VaughnLuce/LineFollowingRobot/README.md

# Line Following Robot
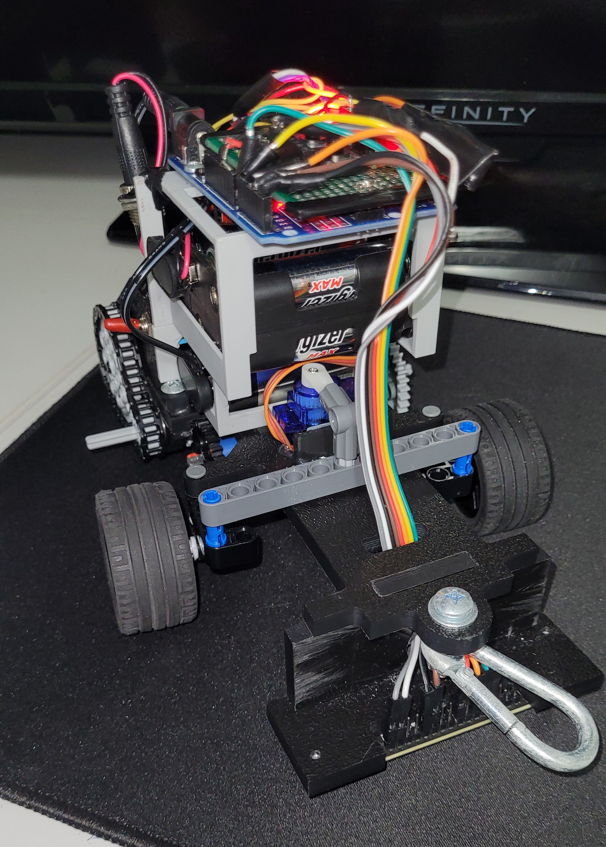
[picture p1: Images/Top.jpg]

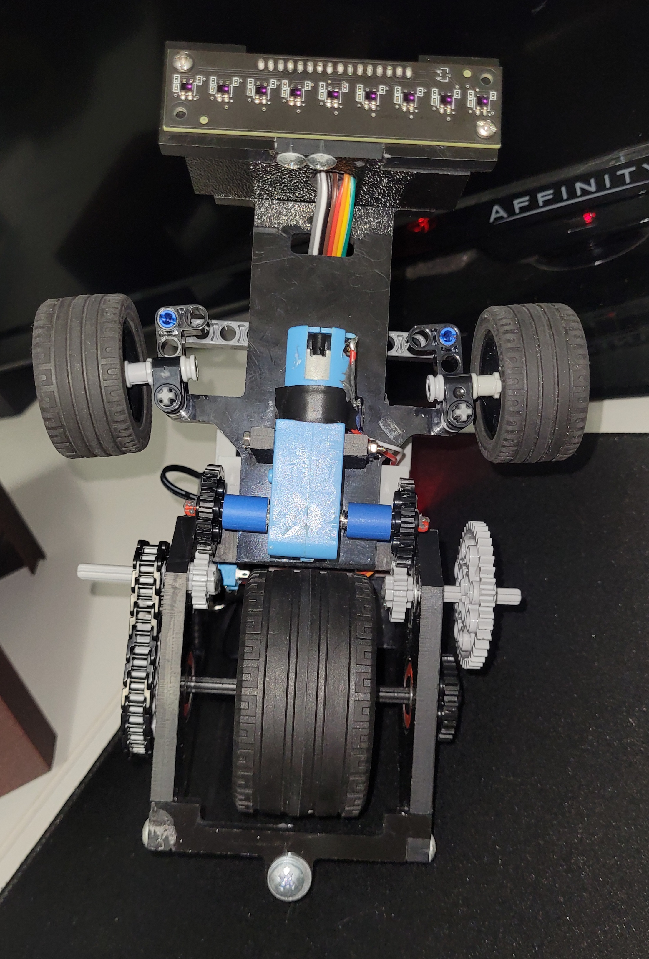
[picture p2: Images/Bottom.jpg]
