VaughnLuce/LineFollowingRobot/FinalDesignPackage.pdf

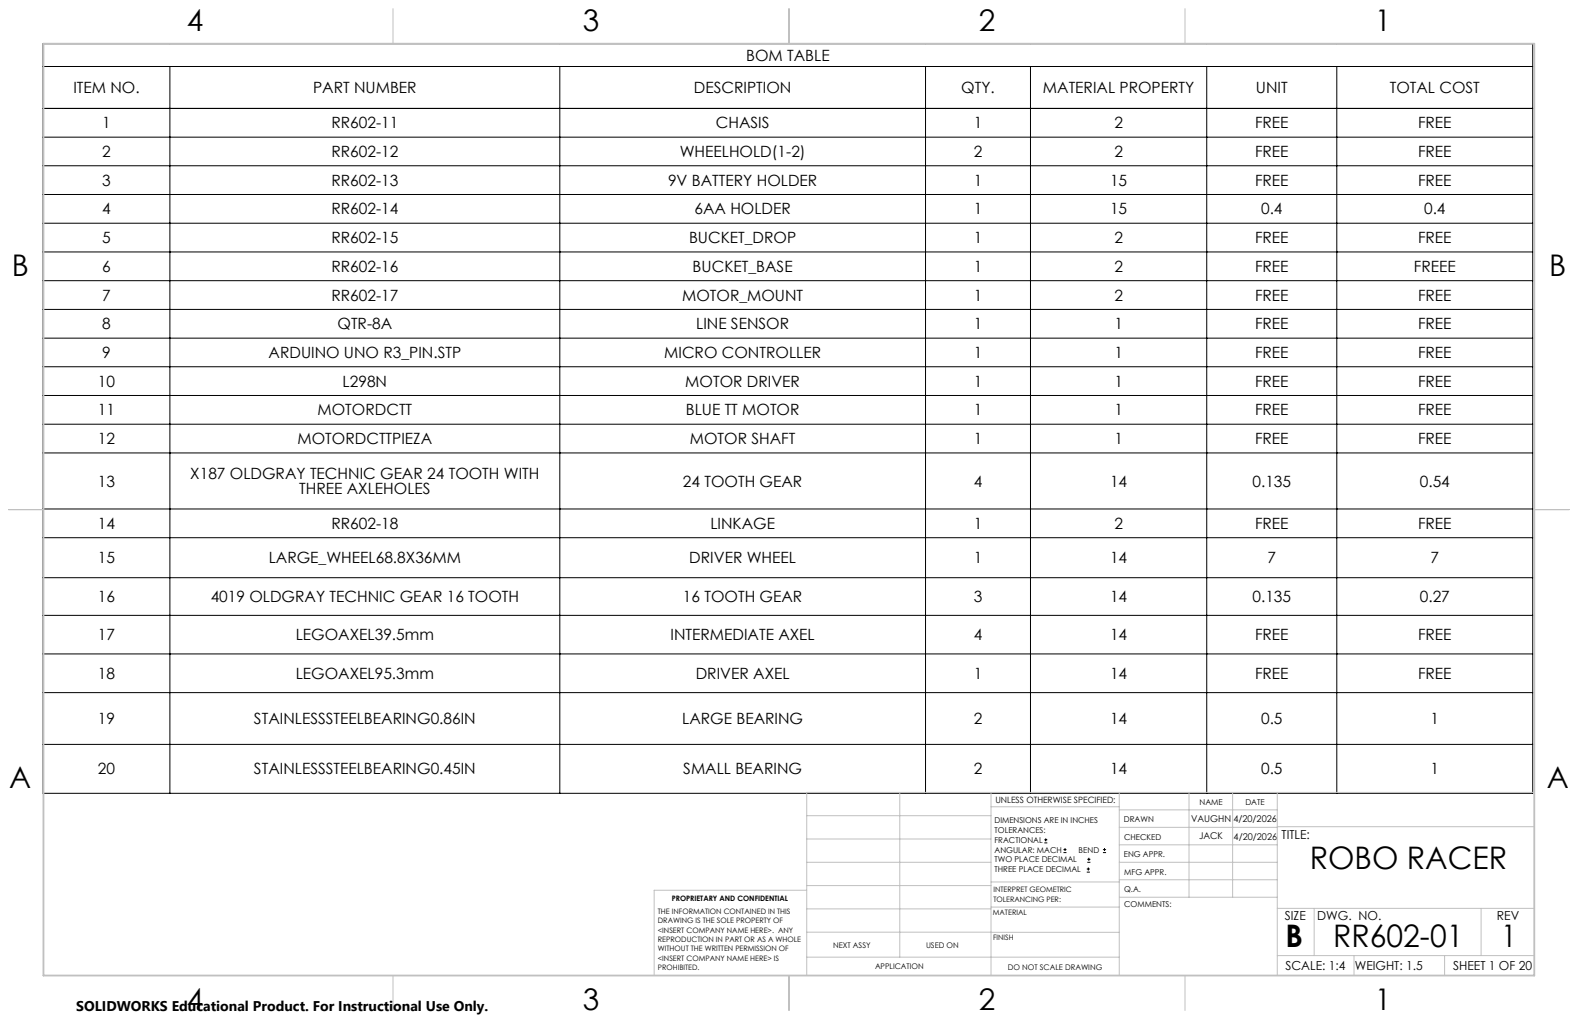
[picture p3: page 1]
BOM TABLE; ITEM NO.; PART NUMBER; DESCRIPTION; QTY.; MATERIAL PROPERTY; UNIT; TOTAL COST; 9V BATTERY HOLDER; FREE; 6AA HOLDER; QTR-8A; LINE SENSOR; ARDUINO UNO R3_PIN.STP; MICRO CONTROLLER; MOTOR DRIVER; MOTORDCTT; BLUE TT MOTOR; MOTORDCTTPIEZA; MOTOR SHAFT; X187 OLDGRAY TECHNIC GEAR 24 TOOTH WITH; THREE AXLEHOLES; 24 TOOTH GEAR; LARGE_WHEEL68.8X36MM; DRIVER WHEEL; 4019 OLDGRAY TECHNIC GEAR 16 TOOTH; 16 TOOTH GEAR; LEGOAXEL39.5mm; INTERMEDIATE AXEL; LEGOAXEL95.3mm; DRIVER AXEL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

UNLESS OTHERWISE SPECIFIED: | | NAME | DATE
DIMENSIONS ARE IN INCHES TOLERANCES: FRACTIONAL ANGULAR: MACH BEND TWO PLACE DECIMAL THREE PLACE DECIMAL | DRAWN | VAUGHN | 4/20/2026

CHECKED | JACK | 4/20/2026 | TITLE: ROBO RACER

ENG APPR.
MFG APPR.

INTERPRET GEOMETRIC TOLERANCING PER: | Q.A.
MATERIAL | | SIZE B | DWG. NO. RR602-01 | REV 1

PROPRIETARY AND CONFIDENTIAL
THE INFORMATION CONTAINED IN THIS
DRAWING IS THE SOLE PROPERTY OF
<INSERT COMPANY NAME HERE>. ANY
REPRODUCTION IN PART OR AS A WHOLE
WITHOUT THE WRITTEN PERMISSION OF
<INSERT COMPANY NAME HERE> IS
PROHIBITED.

NEXT ASSY | USED ON | FINISH

APPLICATION | DO NOT SCALE DRAWING | | SCALE: 1:4 | WEIGHT: 1.5 | SHEET 1 OF 20

SOLIDWORKS Educational Product. For Instructional Use Only.

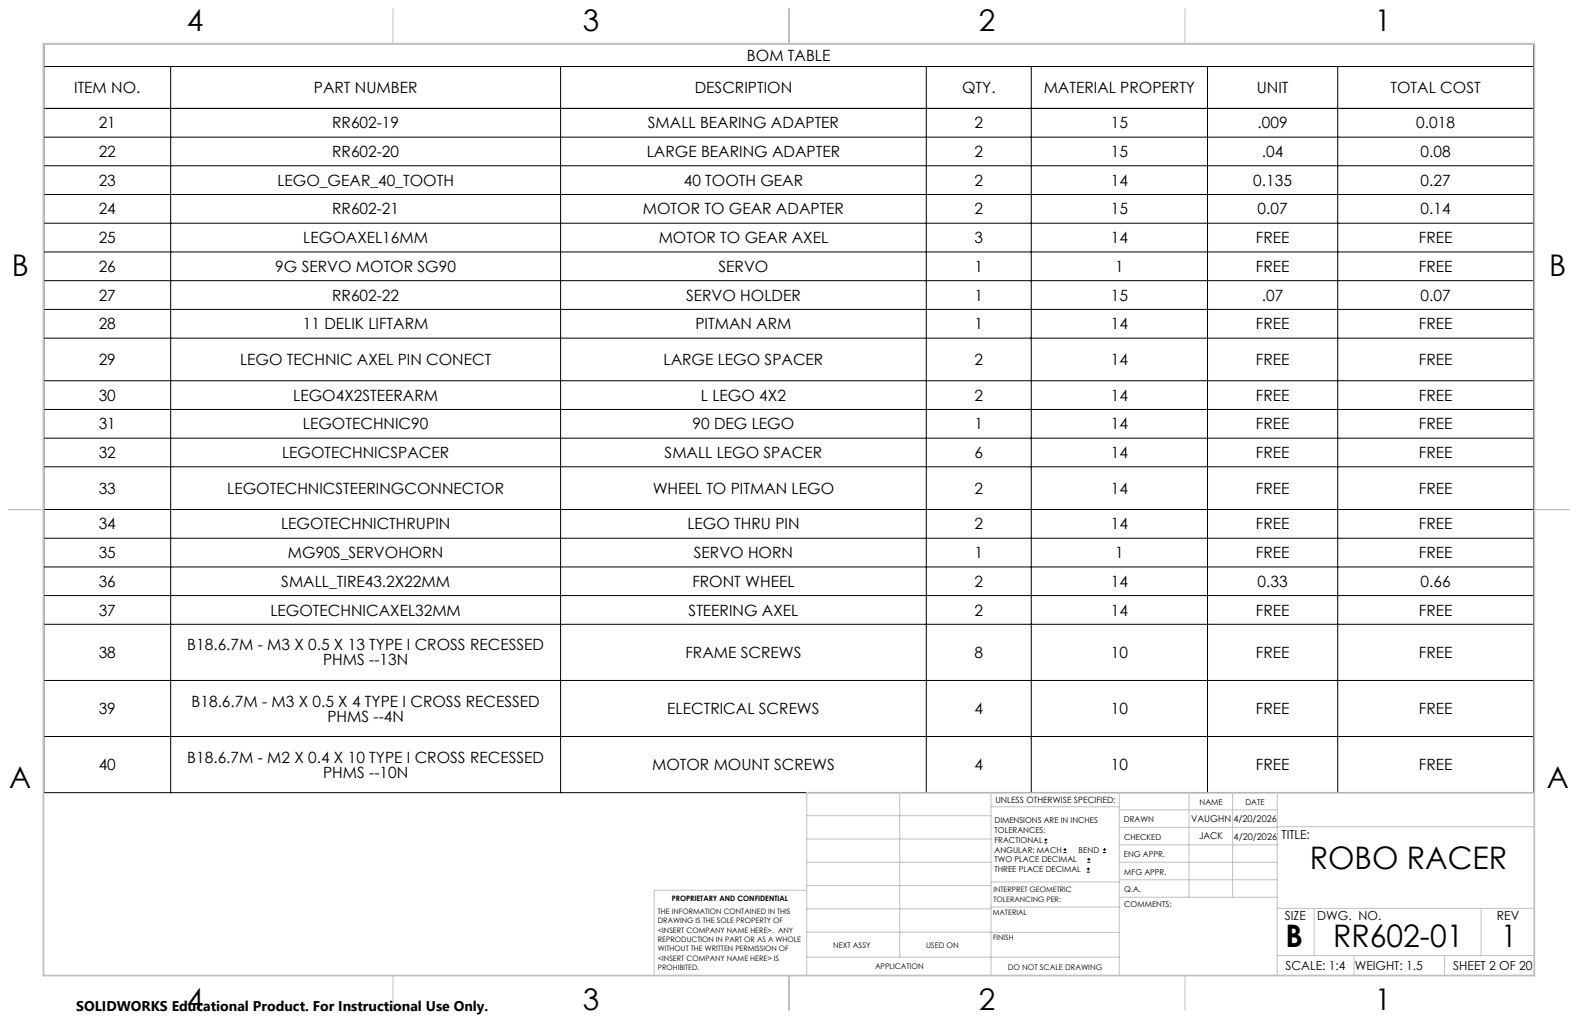
[picture p4: page 2]
BOM TABLE; ITEM NO.; PART NUMBER; DESCRIPTION; QTY.; MATERIAL PROPERTY; UNIT; TOTAL COST; SMALL BEARING ADAPTER; LARGE BEARING ADAPTER; LEGO_GEAR_40_TOOTH; 40 TOOTH GEAR; MOTOR TO GEAR ADAPTER; LEGOAXEL16MM; MOTOR TO GEAR AXEL; FREE; 9G SERVO MOTOR SG90; SERVO; SERVO HOLDER; 11 DELIK LIFTARM; PITMAN ARM; LEGO TECHNIC AXEL PIN CONECT; LARGE LEGO SPACER; LEGO4X2STEERARM; L LEGO 4X2; LEGOTECHNIC90; 90 DEG LEGO; LEGOTECHNICSPACER; SMALL LEGO SPACER; LEGOTECHNICSTEERINGCONNECTOR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

CHECKED | JACK | 4/20/2026 | TITLE: ROBO RACER

ENG APPR.
MFG APPR.

INTERPRET GEOMETRIC TOLERANCING PER: | Q.A.

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

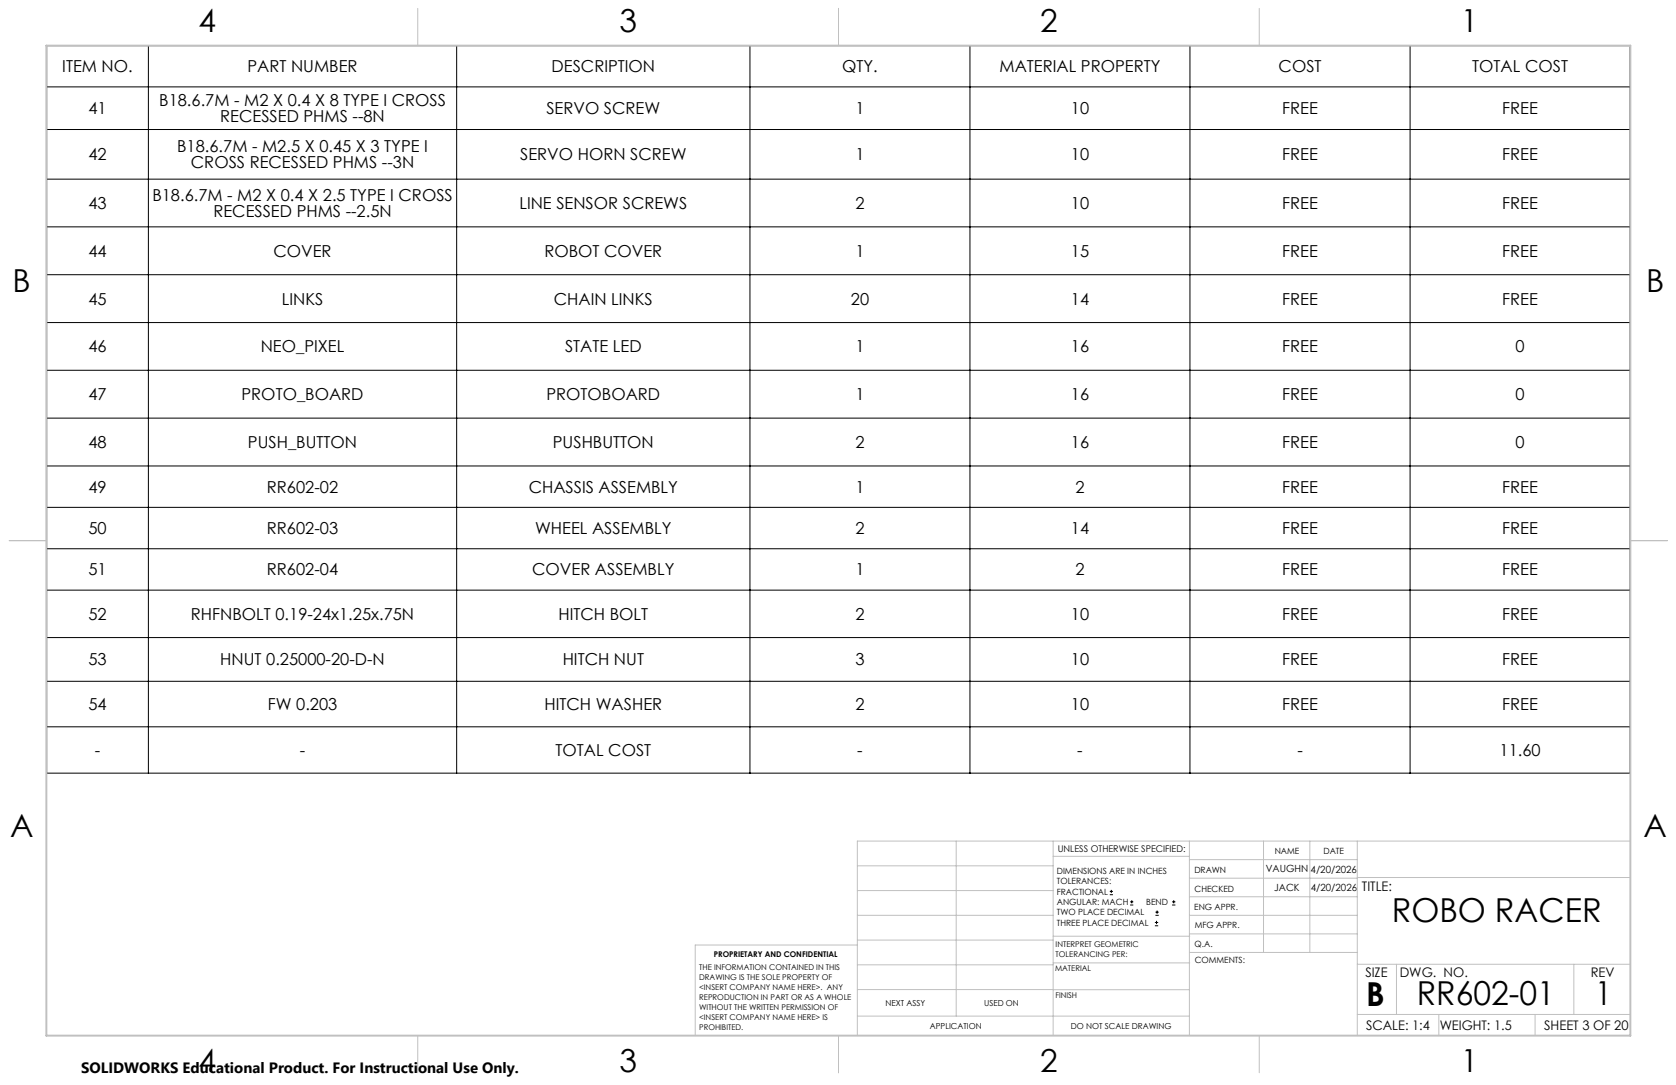
[picture p5: page 3]
SCALE: 1:4; WEIGHT: 1.5; DWG. NO.; REV

ITEM NO. | PART NUMBER | DESCRIPTION | QTY. | MATERIAL PROPERTY | COST | TOTAL COST
41 | B18.6.7M - M2 X 0.4 X 8 TYPE I CROSS RECESSED PHMS --8N | SERVO SCREW | 1 | 10 | FREE | FREE

42 | B18.6.7M - M2.5 X 0.45 X 3 TYPE I CROSS RECESSED PHMS --3N | SERVO HORN SCREW | 1 | 10 | FREE | FREE

43 | B18.6.7M - M2 X 0.4 X 2.5 TYPE I CROSS RECESSED PHMS --2.5N | LINE SENSOR SCREWS | 2 | 10 | FREE | FREE

44 | COVER | ROBOT COVER | 1 | 15 | FREE | FREE

45 | LINKS | CHAIN LINKS | 20 | 14 | FREE | FREE

46 | NEO_PIXEL | STATE LED | 1 | 16 | FREE | 0

47 | PROTO_BOARD | PROTOBOARD | 1 | 16 | FREE | 0

48 | PUSH_BUTTON | PUSHBUTTON | 2 | 16 | FREE | 0

49 | RR602-02 | CHASSIS ASSEMBLY | 1 | 2 | FREE | FREE
50 | RR602-03 | WHEEL ASSEMBLY | 2 | 14 | FREE | FREE
51 | RR602-04 | COVER ASSEMBLY | 1 | 2 | FREE | FREE

52 | RHFNBOLT 0.19-24x1.25x.75N | HITCH BOLT | 2 | 10 | FREE | FREE

53 | HNUT 0.25000-20-D-N | HITCH NUT | 3 | 10 | FREE | FREE

54 | FW 0.203 | HITCH WASHER | 2 | 10 | FREE | FREE

- | - | TOTAL COST | - | - | - | 11.60

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

CHECKED | JACK | 4/20/2026 | TITLE: ROBO RACER

ENG APPR.
MFG APPR.

INTERPRET GEOMETRIC TOLERANCING PER: | Q.A.

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

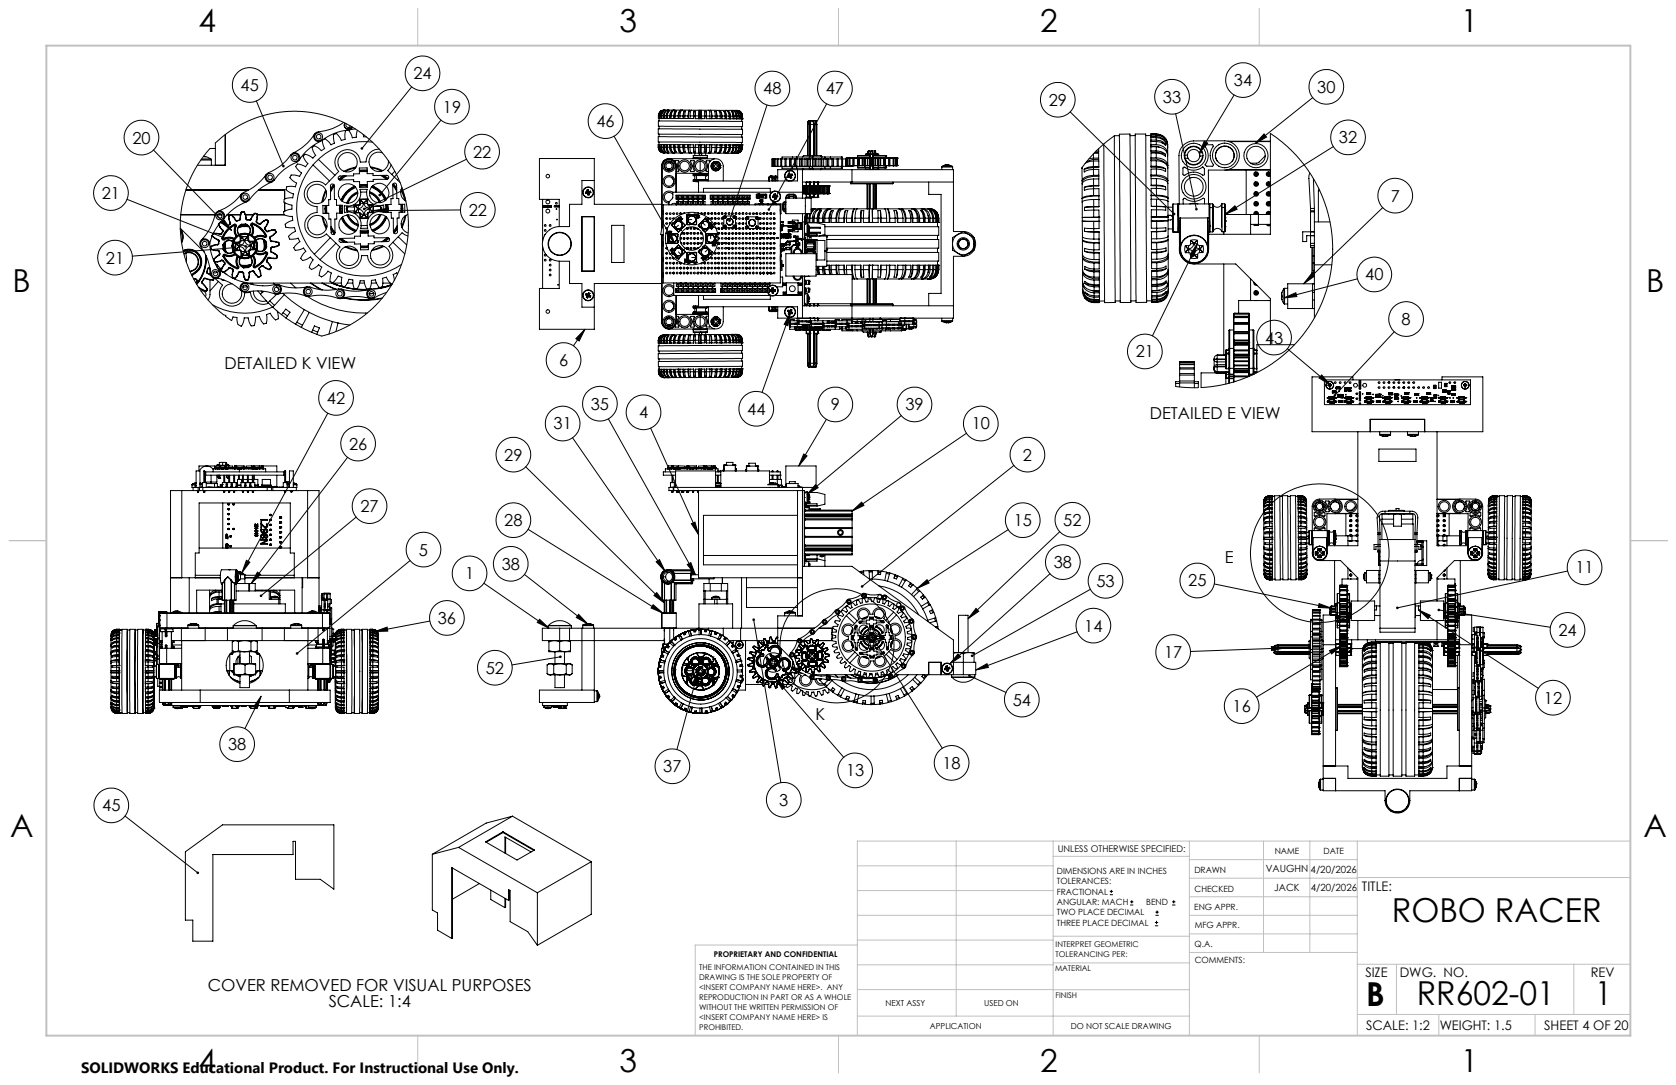
[picture p6: page 4]
DETAILED E VIEW; DETAILED K VIEW; SCALE: 1:4; SCALE: 1:2; WEIGHT: 1.5; DWG. NO.; REV

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

CHECKED | JACK | 4/20/2026 | TITLE: ROBO RACER

ENG APPR.
MFG APPR.

INTERPRET GEOMETRIC TOLERANCING PER: | Q.A.

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

COVER REMOVED FOR VISUAL PURPOSES

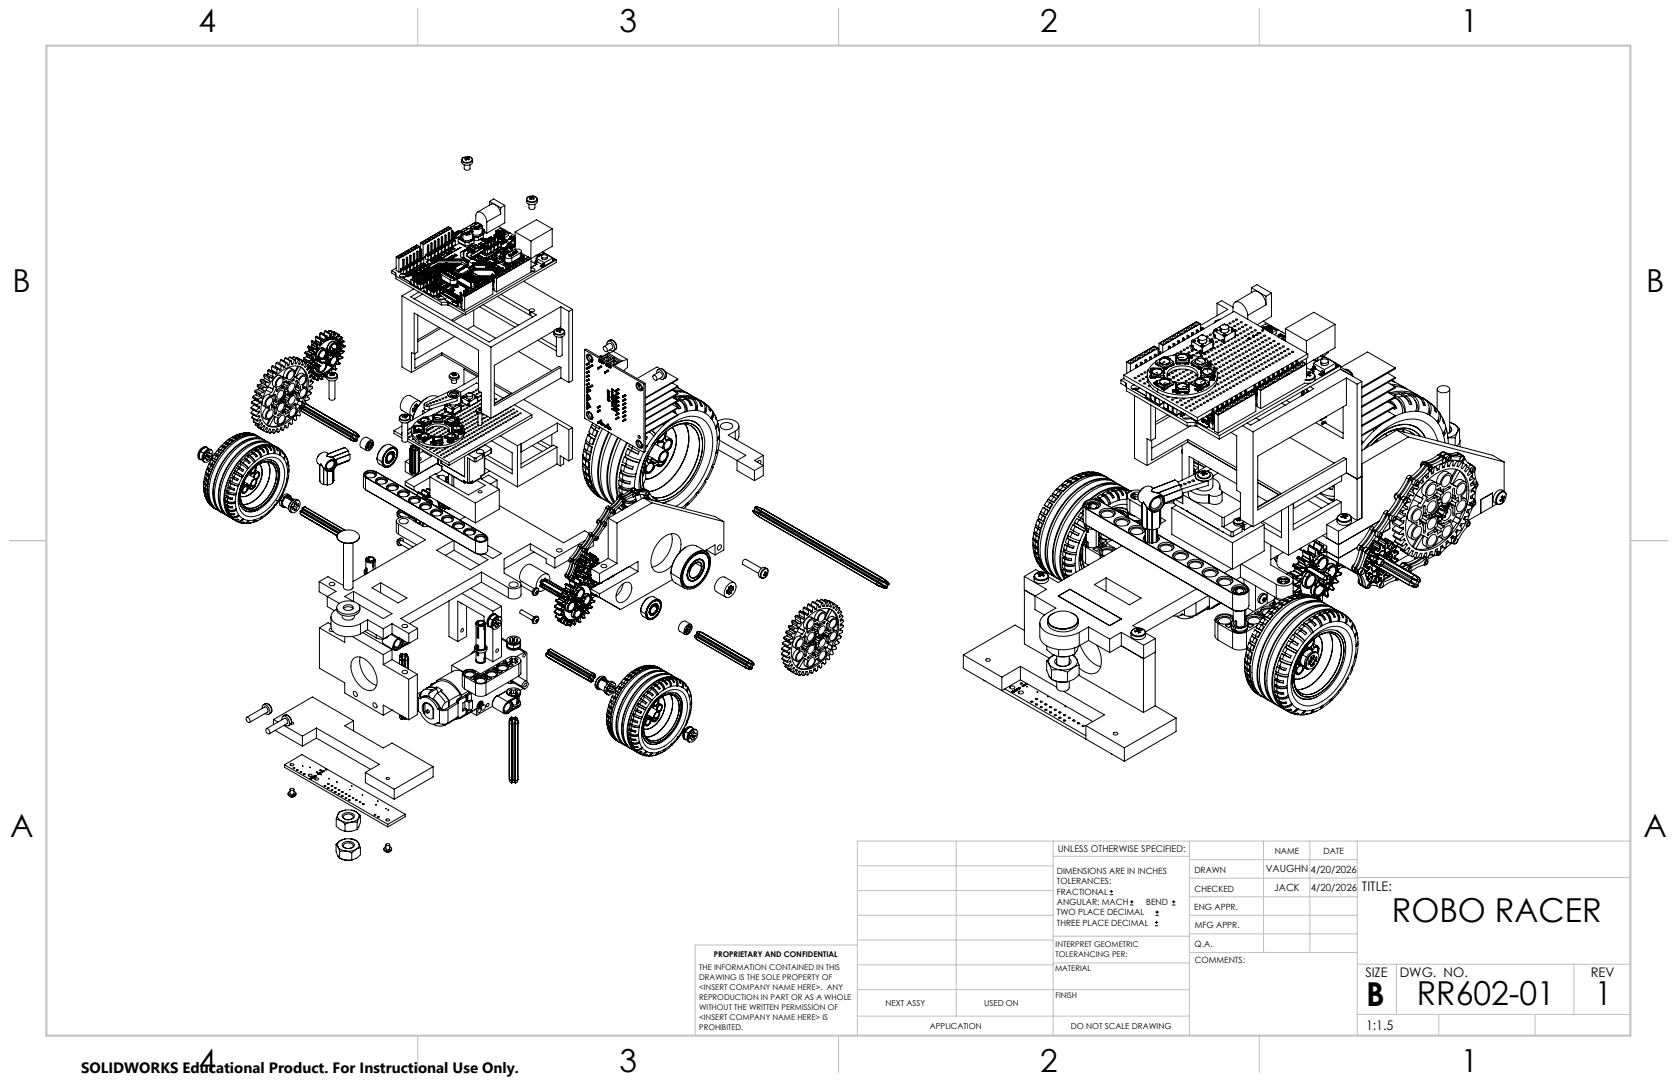
[picture p7: page 5]
DWG. NO.; REV

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

CHECKED | JACK | 4/20/2026 | TITLE: ROBO RACER

ENG APPR.
MFG APPR.

INTERPRET GEOMETRIC TOLERANCING PER: | Q.A.

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

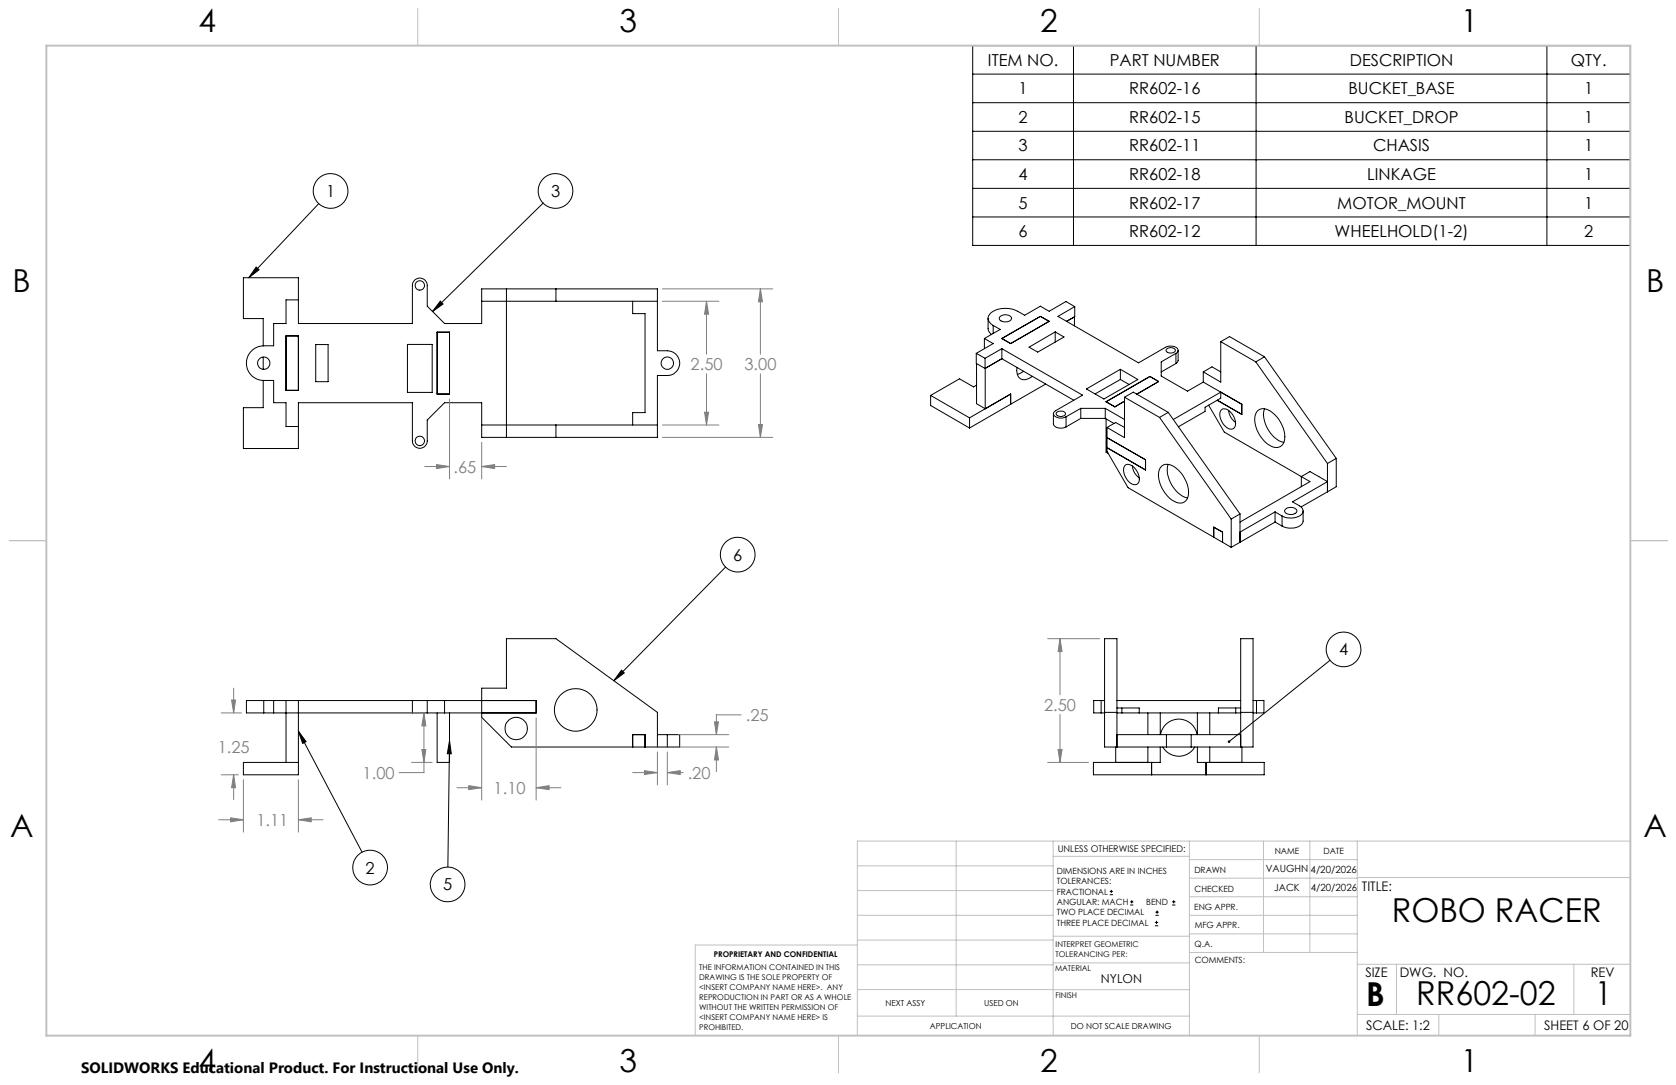
[picture p8: page 6]
DWG. NO.; REV

ITEM NO. | PART NUMBER | DESCRIPTION | QTY.
1 | RR602-16 | BUCKET_BASE | 1
2 | RR602-15 | BUCKET_DROP | 1
3 | RR602-11 | CHASIS | 1
4 | RR602-18 | LINKAGE | 1
5 | RR602-17 | MOTOR_MOUNT | 1
6 | RR602-12 | WHEELHOLD(1-2) | 2

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

CHECKED | JACK | 4/20/2026 | TITLE: ROBO RACER

ENG APPR.
MFG APPR.

INTERPRET GEOMETRIC TOLERANCING PER: | Q.A.

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

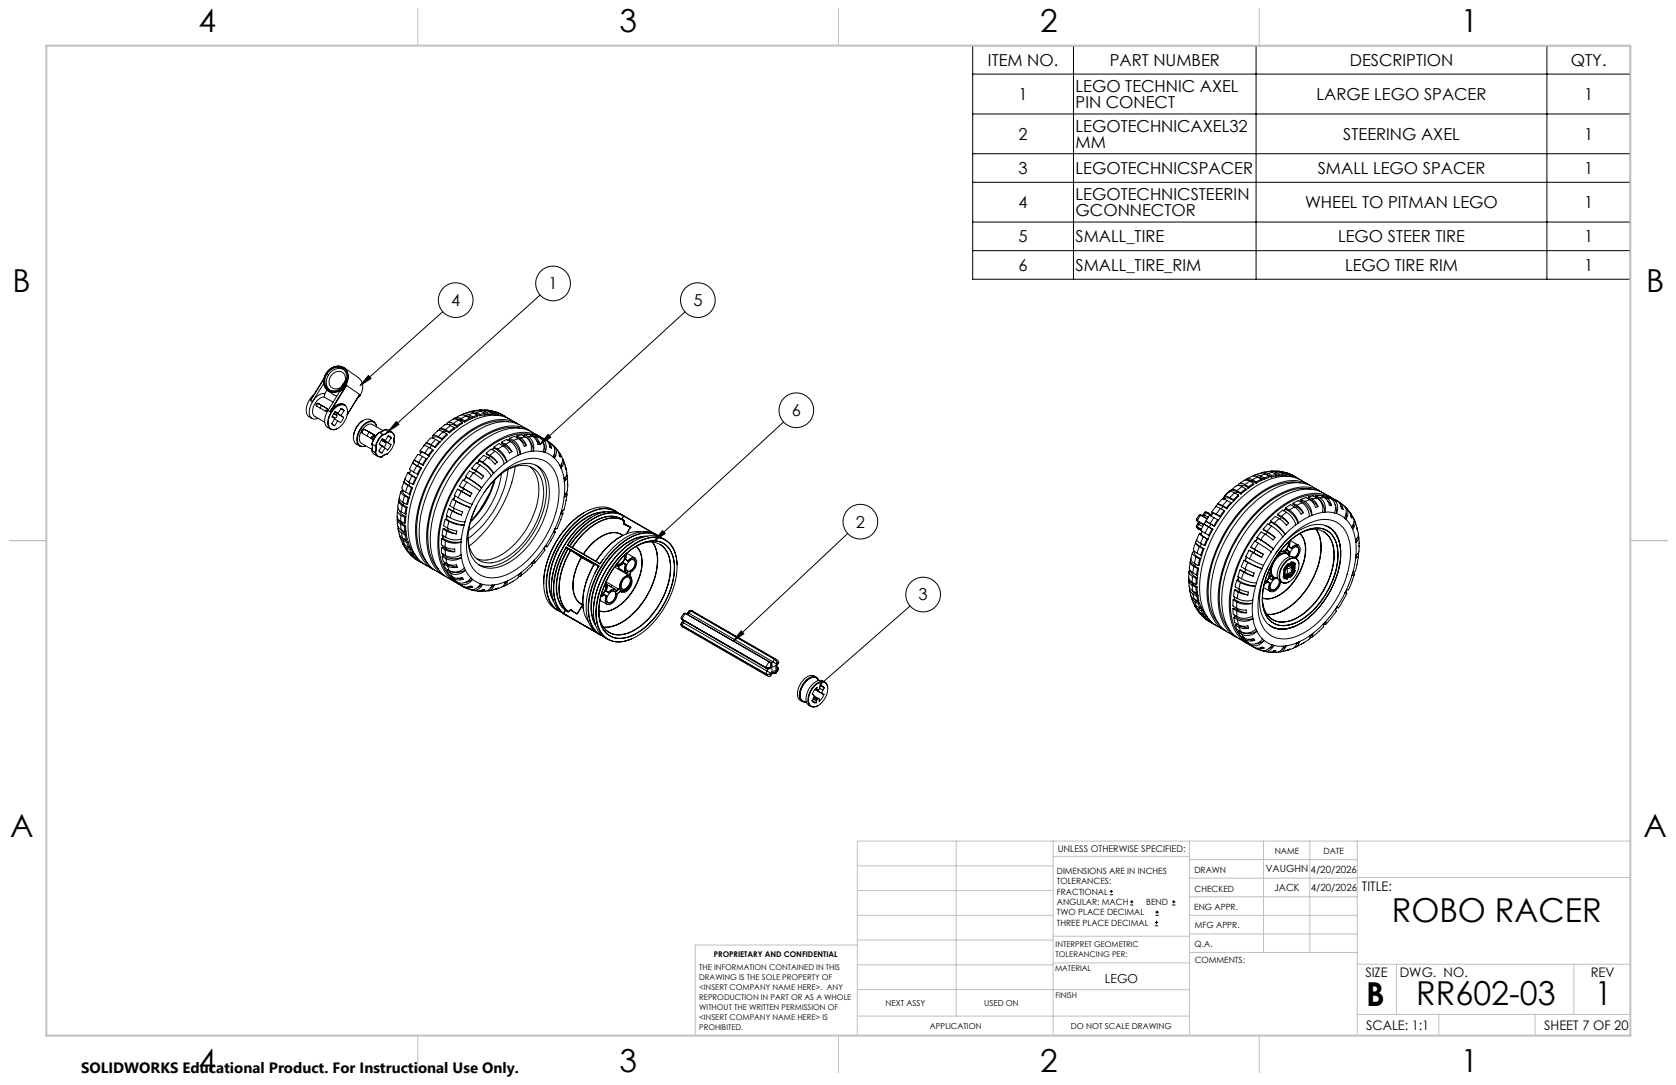
[picture p9: page 7]
DWG. NO.; REV

ITEM NO. | PART NUMBER | DESCRIPTION | QTY.
1 | LEGO TECHNIC AXEL PIN CONECT | LARGE LEGO SPACER | 1
2 | LEGOTECHNICAXEL32 MM | STEERING AXEL | 1
3 | LEGOTECHNICSPACER | SMALL LEGO SPACER | 1
4 | LEGOTECHNICSTEERIN GCONNECTOR | WHEEL TO PITMAN LEGO | 1
5 | SMALL_TIRE | LEGO STEER TIRE | 1
6 | SMALL_TIRE_RIM | LEGO TIRE RIM | 1

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

CHECKED | JACK | 4/20/2026 | TITLE: ROBO RACER

ENG APPR.
MFG APPR.

INTERPRET GEOMETRIC TOLERANCING PER: | Q.A.

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

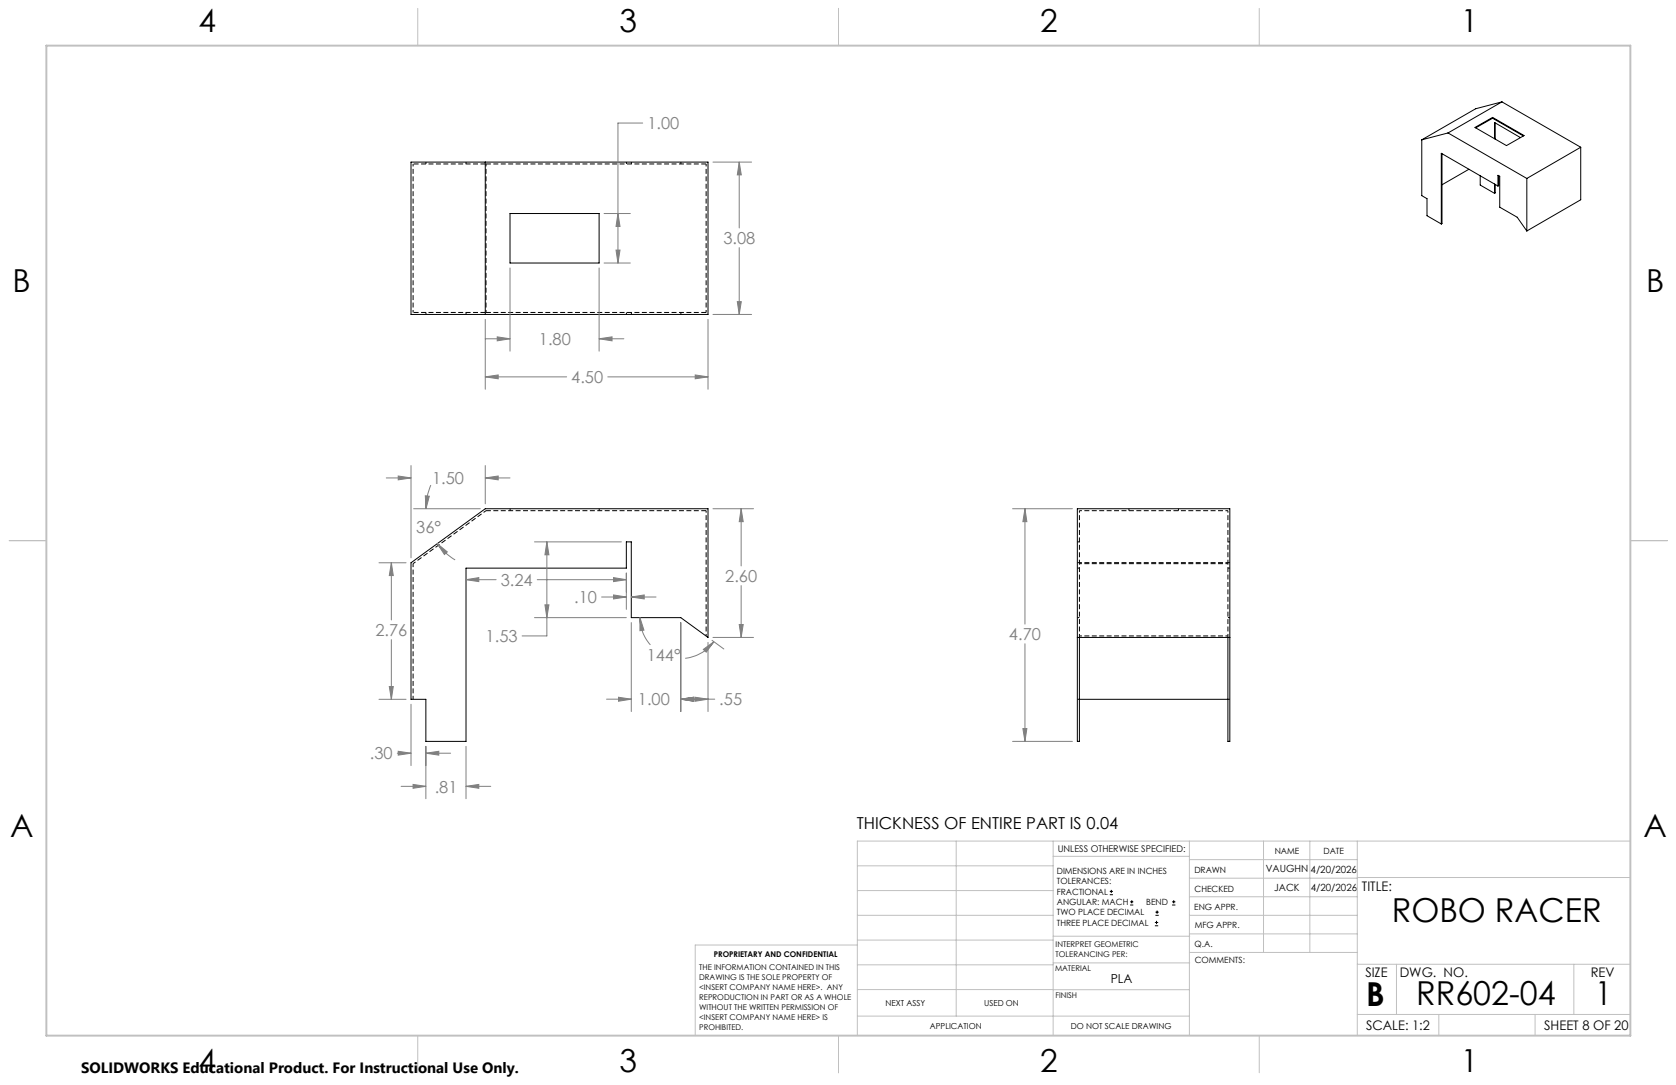
[picture p10: page 8]
THICKNESS OF ENTIRE PART IS 0.04; DWG. NO.; REV; PROHIBITED.; SHEET 8 OF 20

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

CHECKED | JACK | 4/20/2026 | TITLE: ROBO RACER

ENG APPR.
MFG APPR.

INTERPRET GEOMETRIC TOLERANCING PER: | Q.A.

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

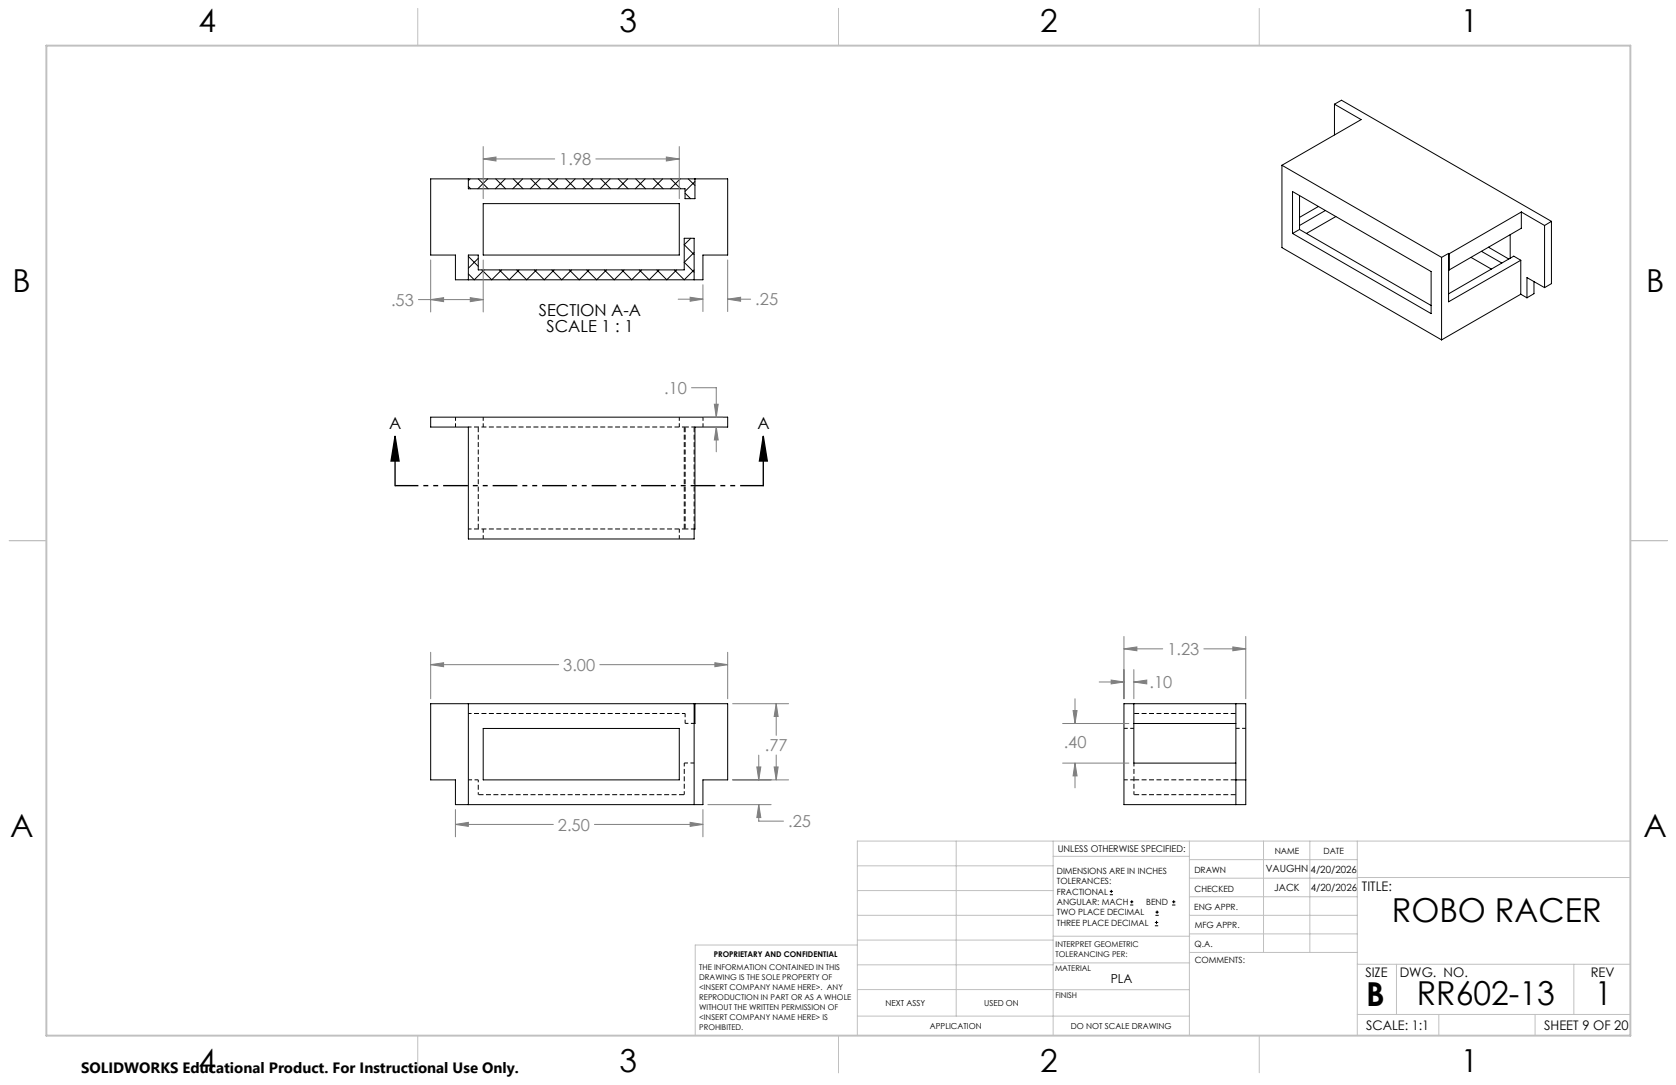
[picture p11: page 9]
.25 SECTION A-A; SCALE 1 : 1; DWG. NO.; REV

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

CHECKED | JACK | 4/20/2026 | TITLE: ROBO RACER

ENG APPR.
MFG APPR.

INTERPRET GEOMETRIC TOLERANCING PER: | Q.A.

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

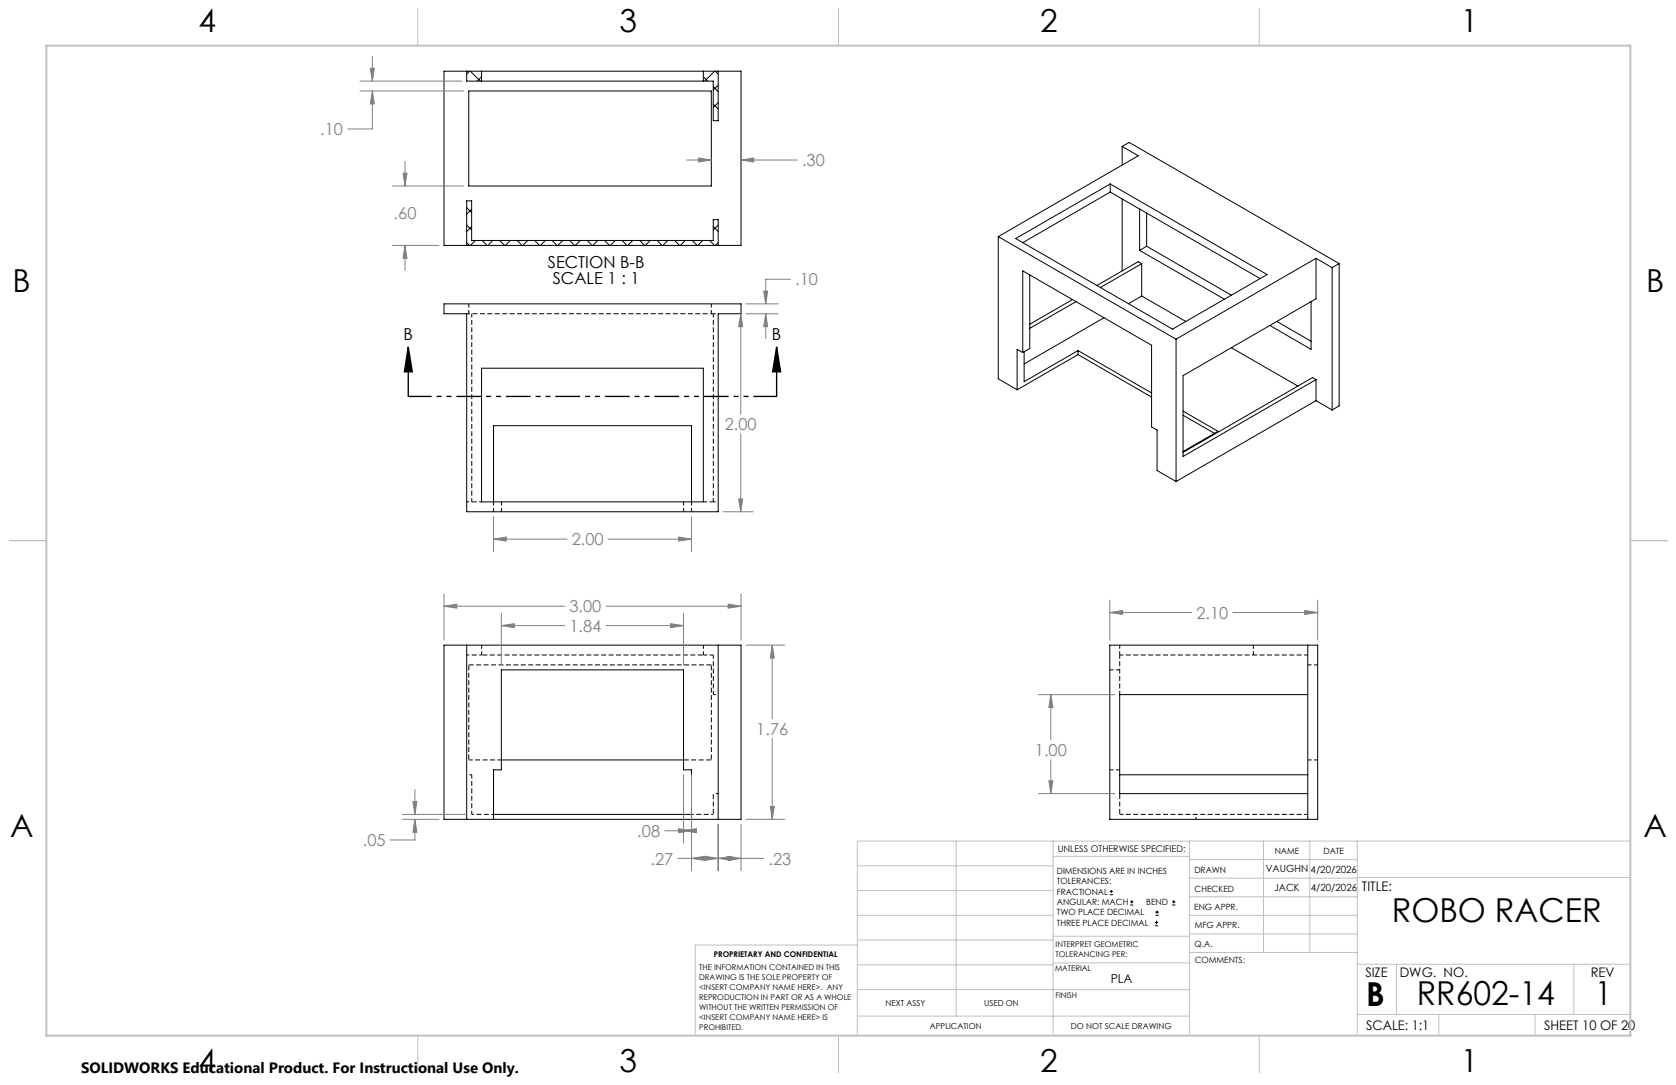
[picture p12: page 10]
SECTION B-B SCALE 1 : 1; DWG. NO.; REV

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

CHECKED | JACK | 4/20/2026 | TITLE: ROBO RACER

ENG APPR.
MFG APPR.

INTERPRET GEOMETRIC TOLERANCING PER: | Q.A.

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

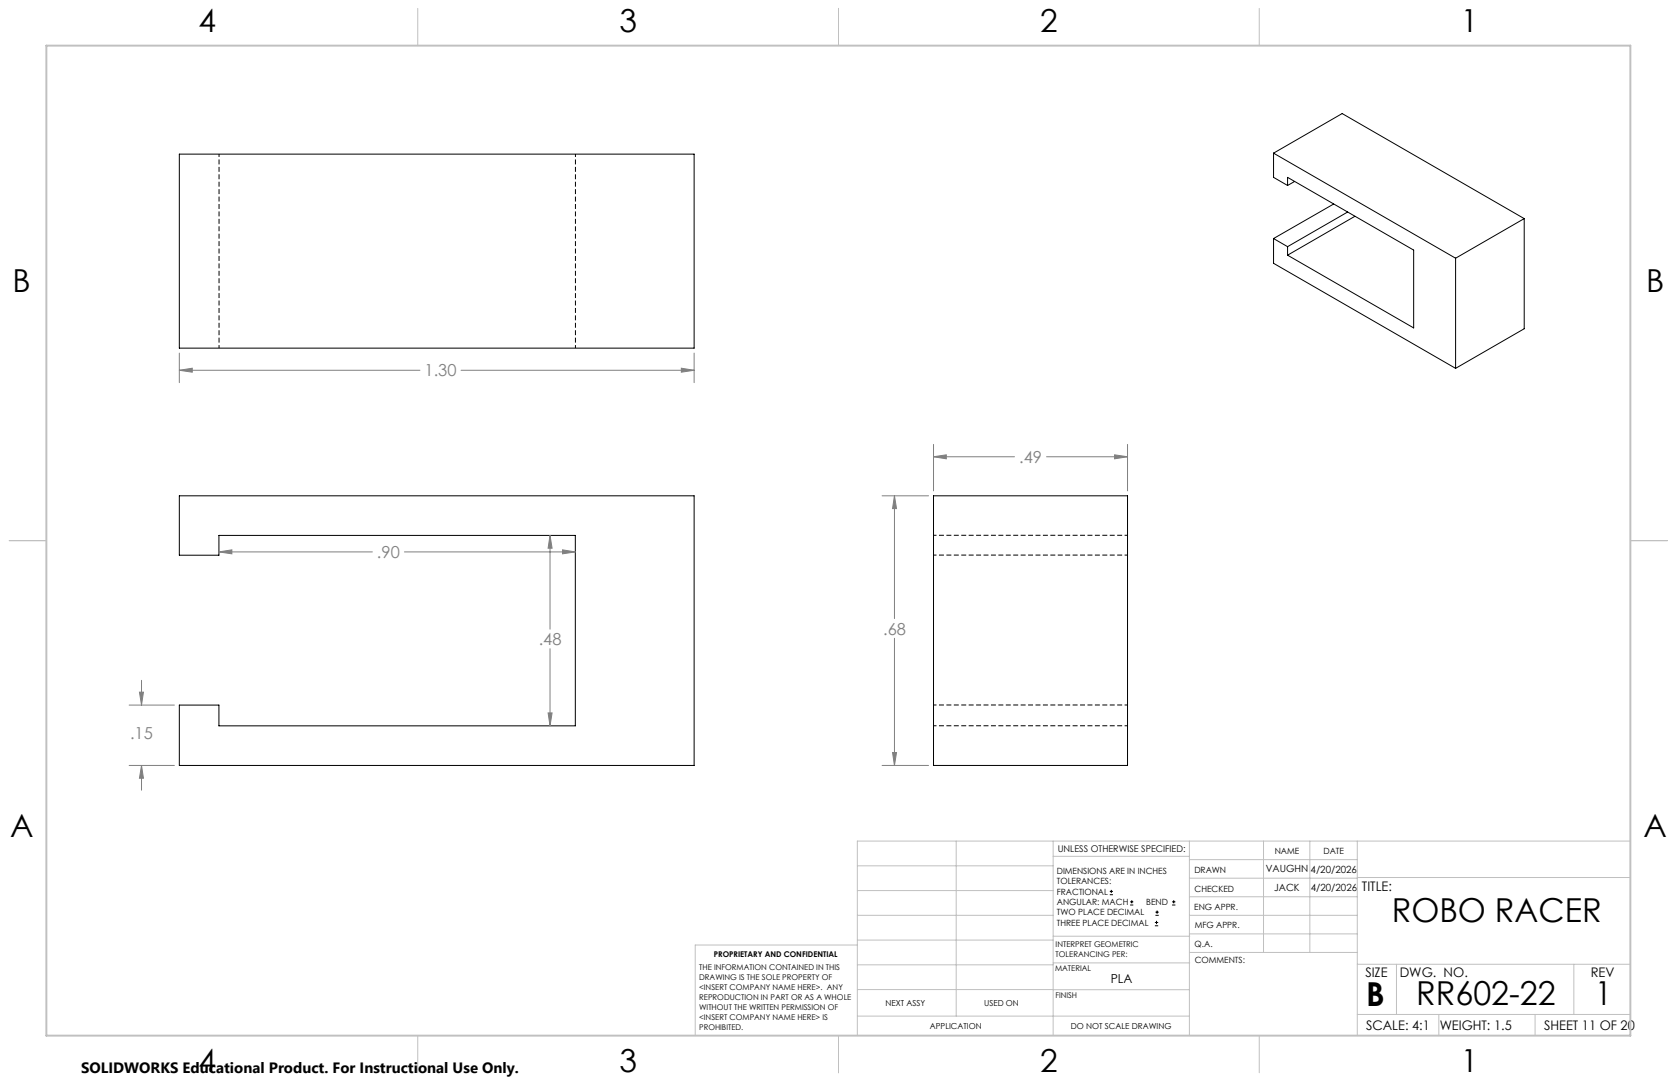
[picture p13: page 11]
SCALE: 4:1; WEIGHT: 1.5; DWG. NO.; REV

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

CHECKED | JACK | 4/20/2026 | TITLE: ROBO RACER

ENG APPR.
MFG APPR.

INTERPRET GEOMETRIC TOLERANCING PER: | Q.A.

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

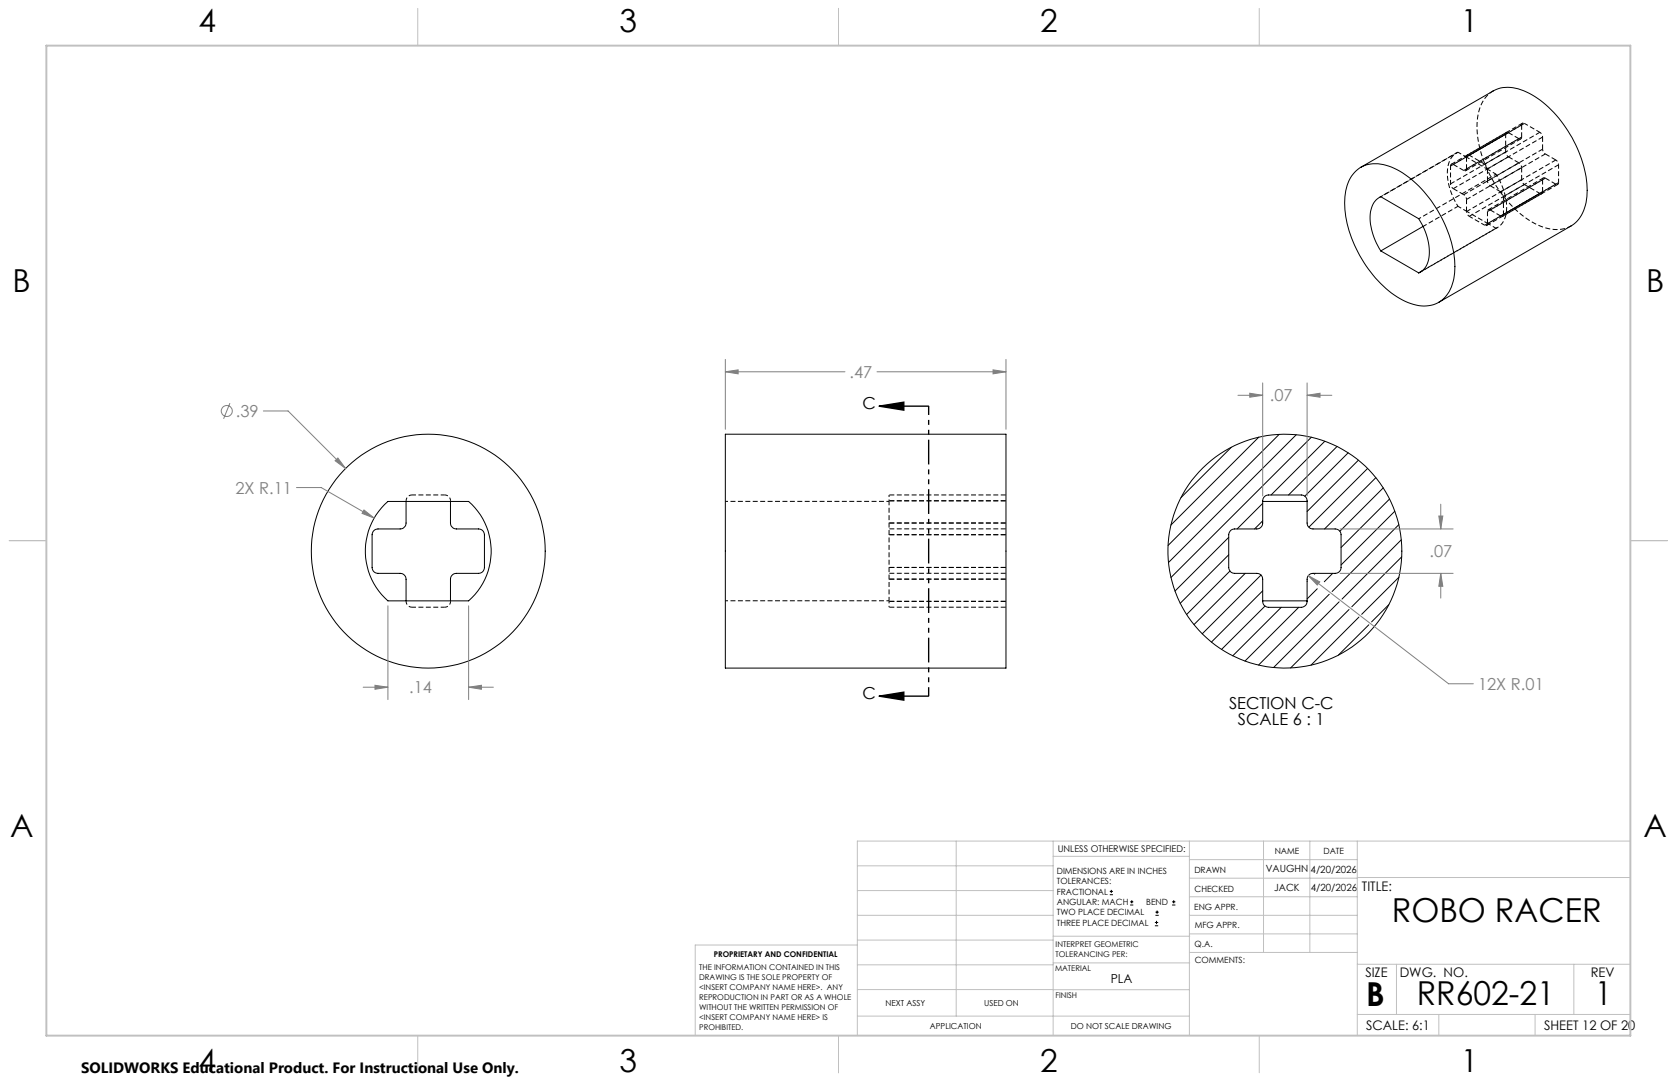
[picture p14: page 12]
SECTION C-C SCALE 6 : 1; SCALE: 6:1; DWG. NO.; REV

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

CHECKED | JACK | 4/20/2026 | TITLE: ROBO RACER

ENG APPR.
MFG APPR.

INTERPRET GEOMETRIC TOLERANCING PER: | Q.A.

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

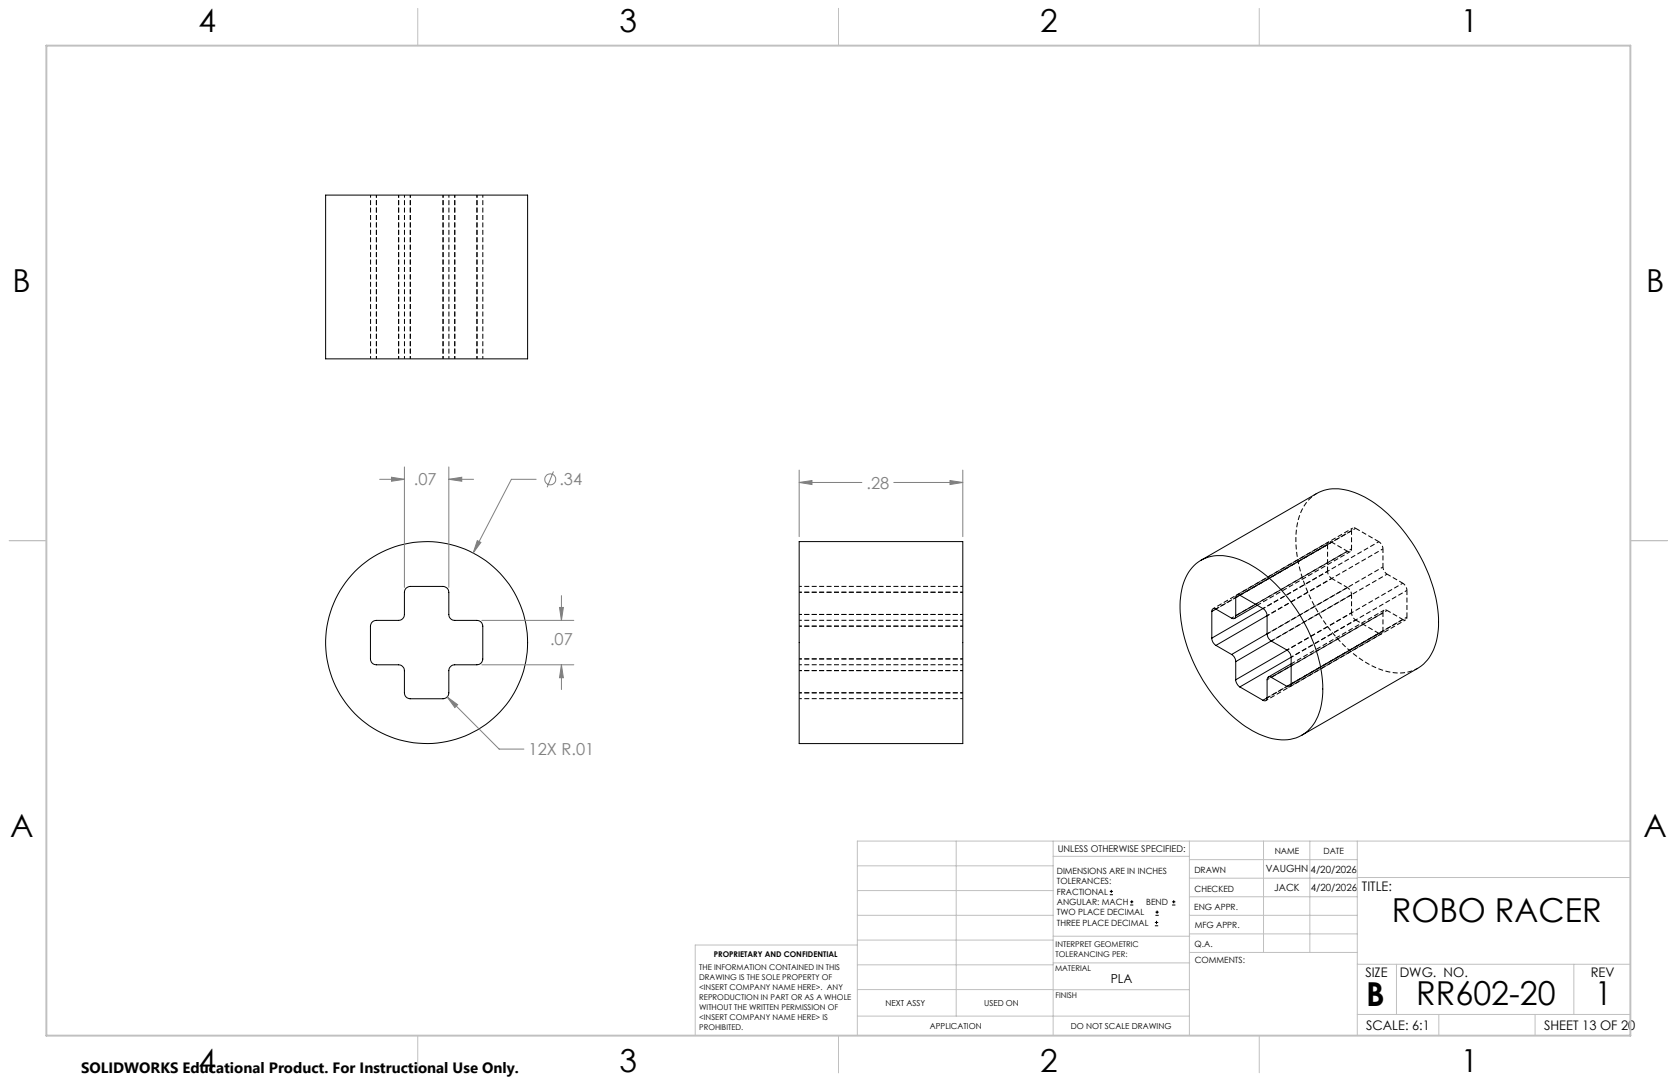
[picture p15: page 13]
SCALE: 6:1; DWG. NO.; REV

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

CHECKED | JACK | 4/20/2026 | TITLE: ROBO RACER

ENG APPR.
MFG APPR.

INTERPRET GEOMETRIC TOLERANCING PER: | Q.A.

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

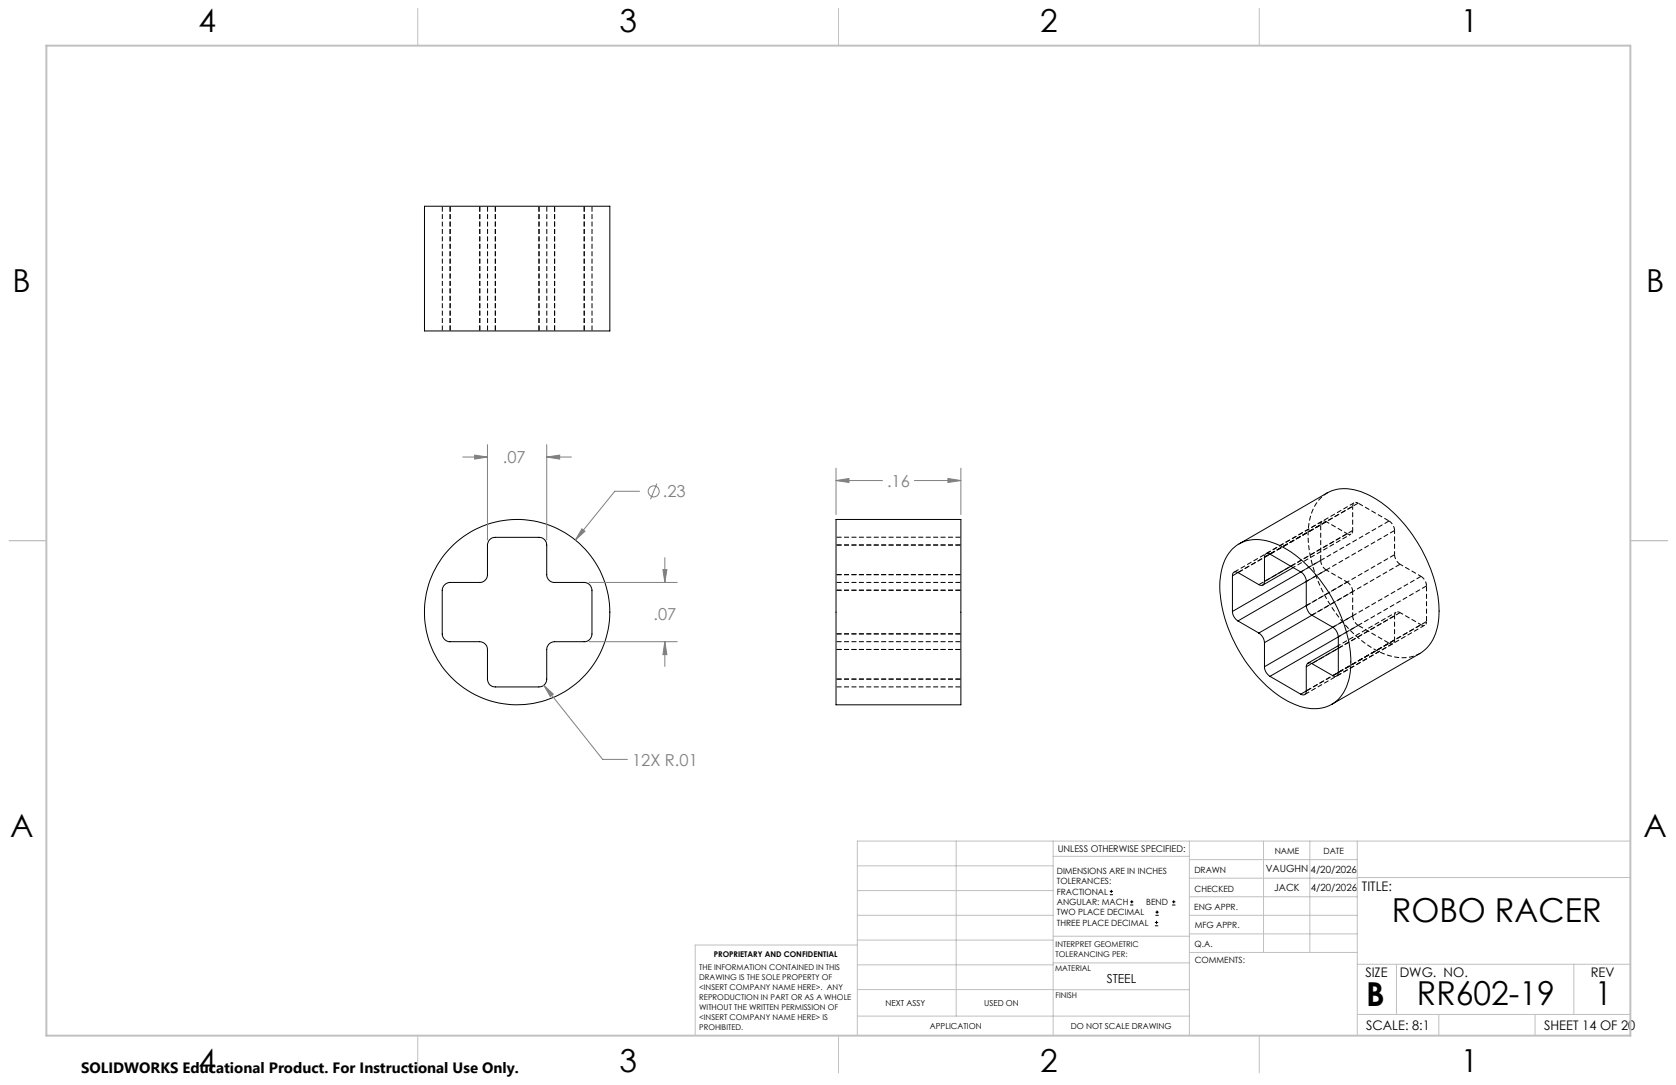
[picture p16: page 14]
SCALE: 8:1; DWG. NO.; REV

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

CHECKED | JACK | 4/20/2026 | TITLE: ROBO RACER

ENG APPR.
MFG APPR.

INTERPRET GEOMETRIC TOLERANCING PER: | Q.A.

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

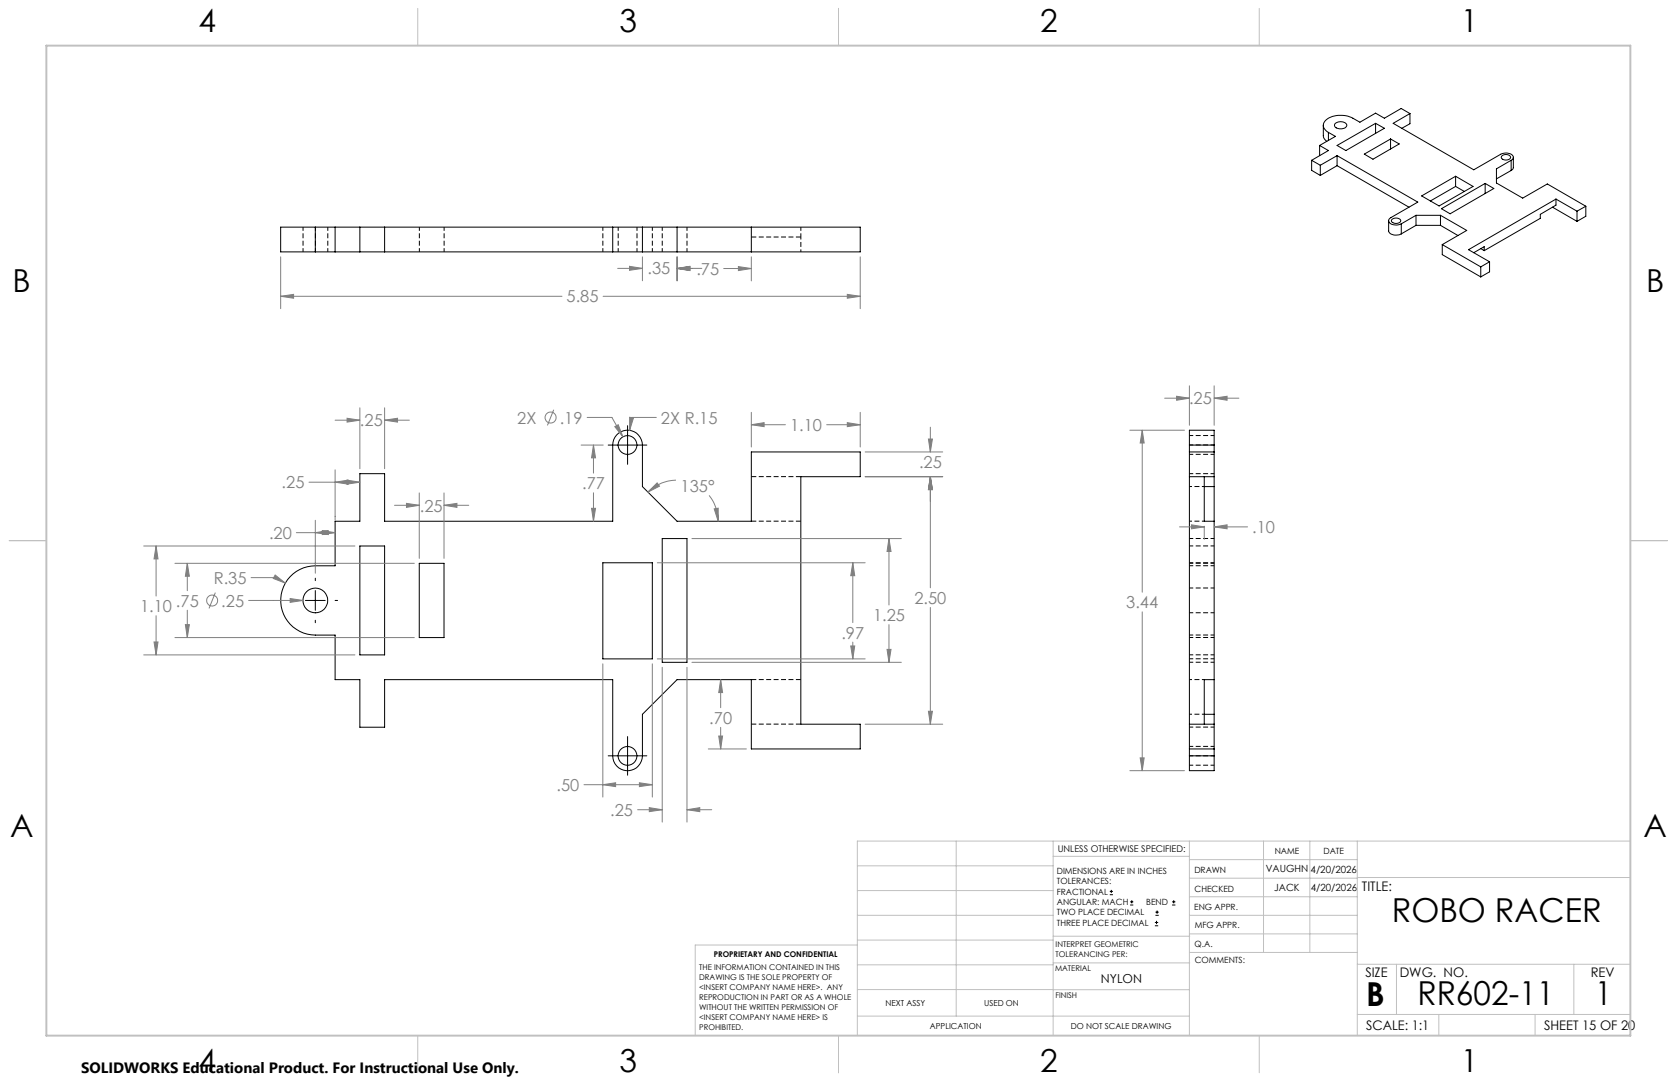
[picture p17: page 15]
DWG. NO.; REV

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

CHECKED | JACK | 4/20/2026 | TITLE: ROBO RACER

ENG APPR.
MFG APPR.

INTERPRET GEOMETRIC TOLERANCING PER: | Q.A.

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

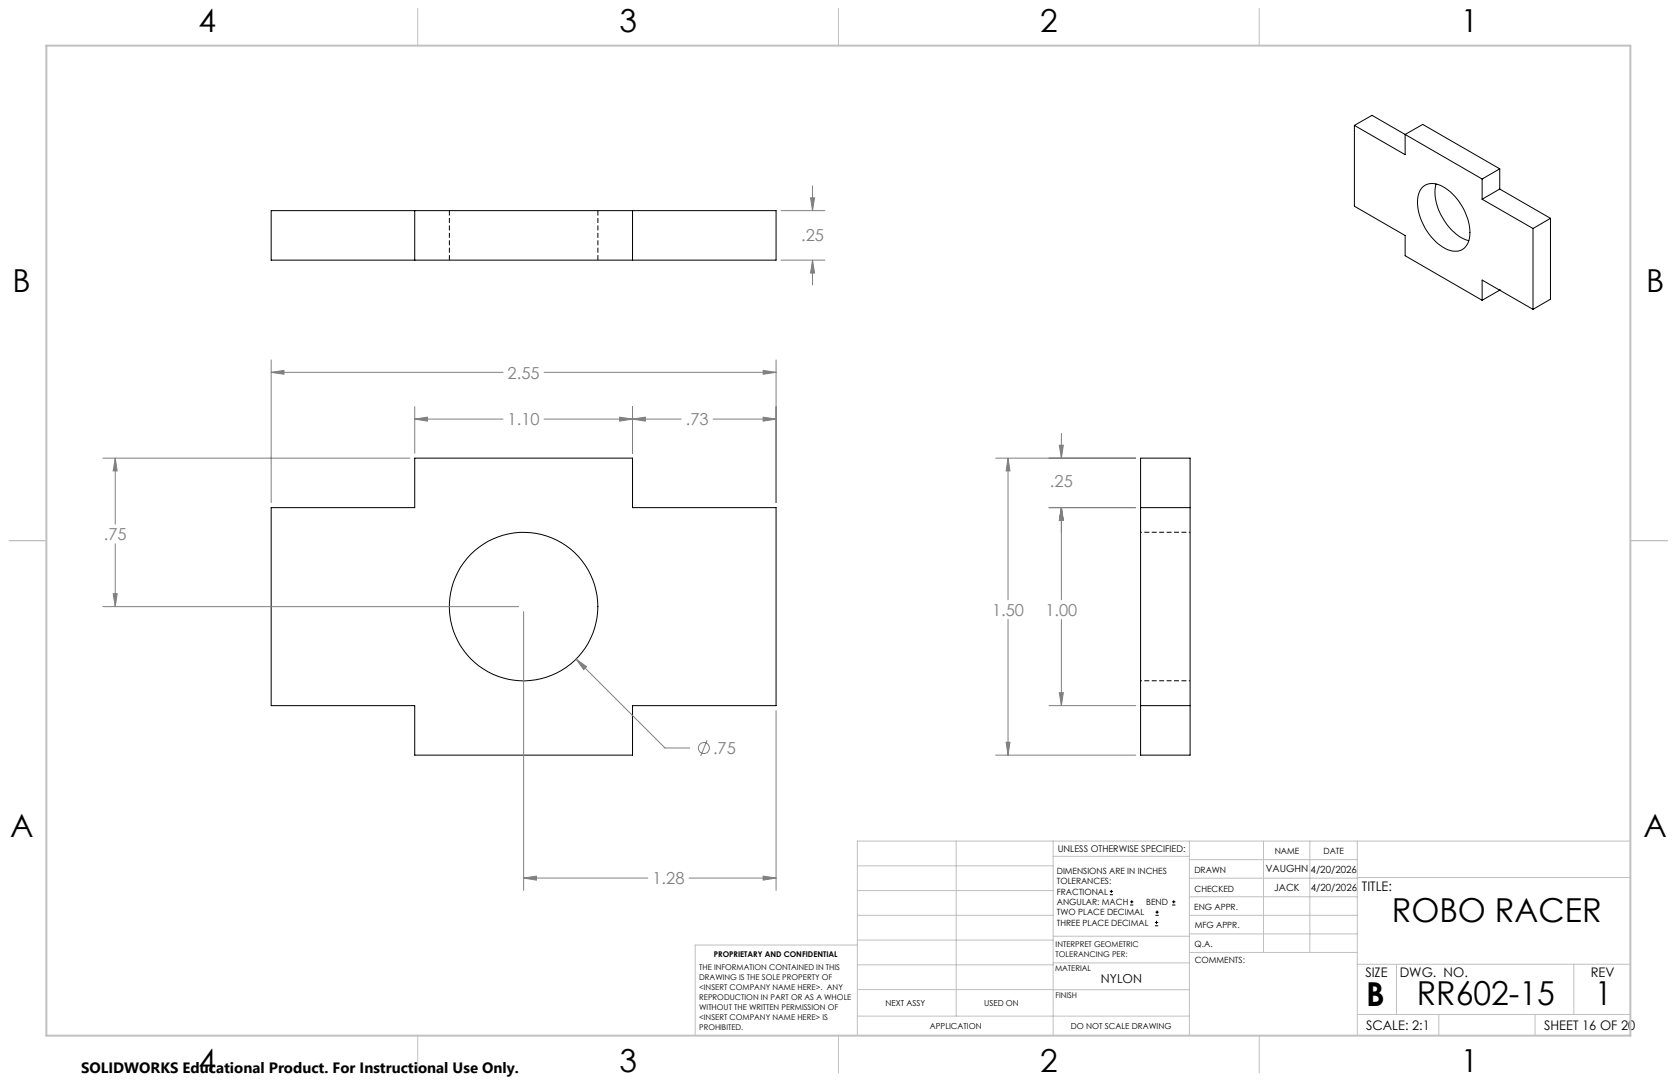
[picture p18: page 16]
SCALE: 2:1; DWG. NO.; REV

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

CHECKED | JACK | 4/20/2026 | TITLE: ROBO RACER

ENG APPR.
MFG APPR.

INTERPRET GEOMETRIC TOLERANCING PER: | Q.A.

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

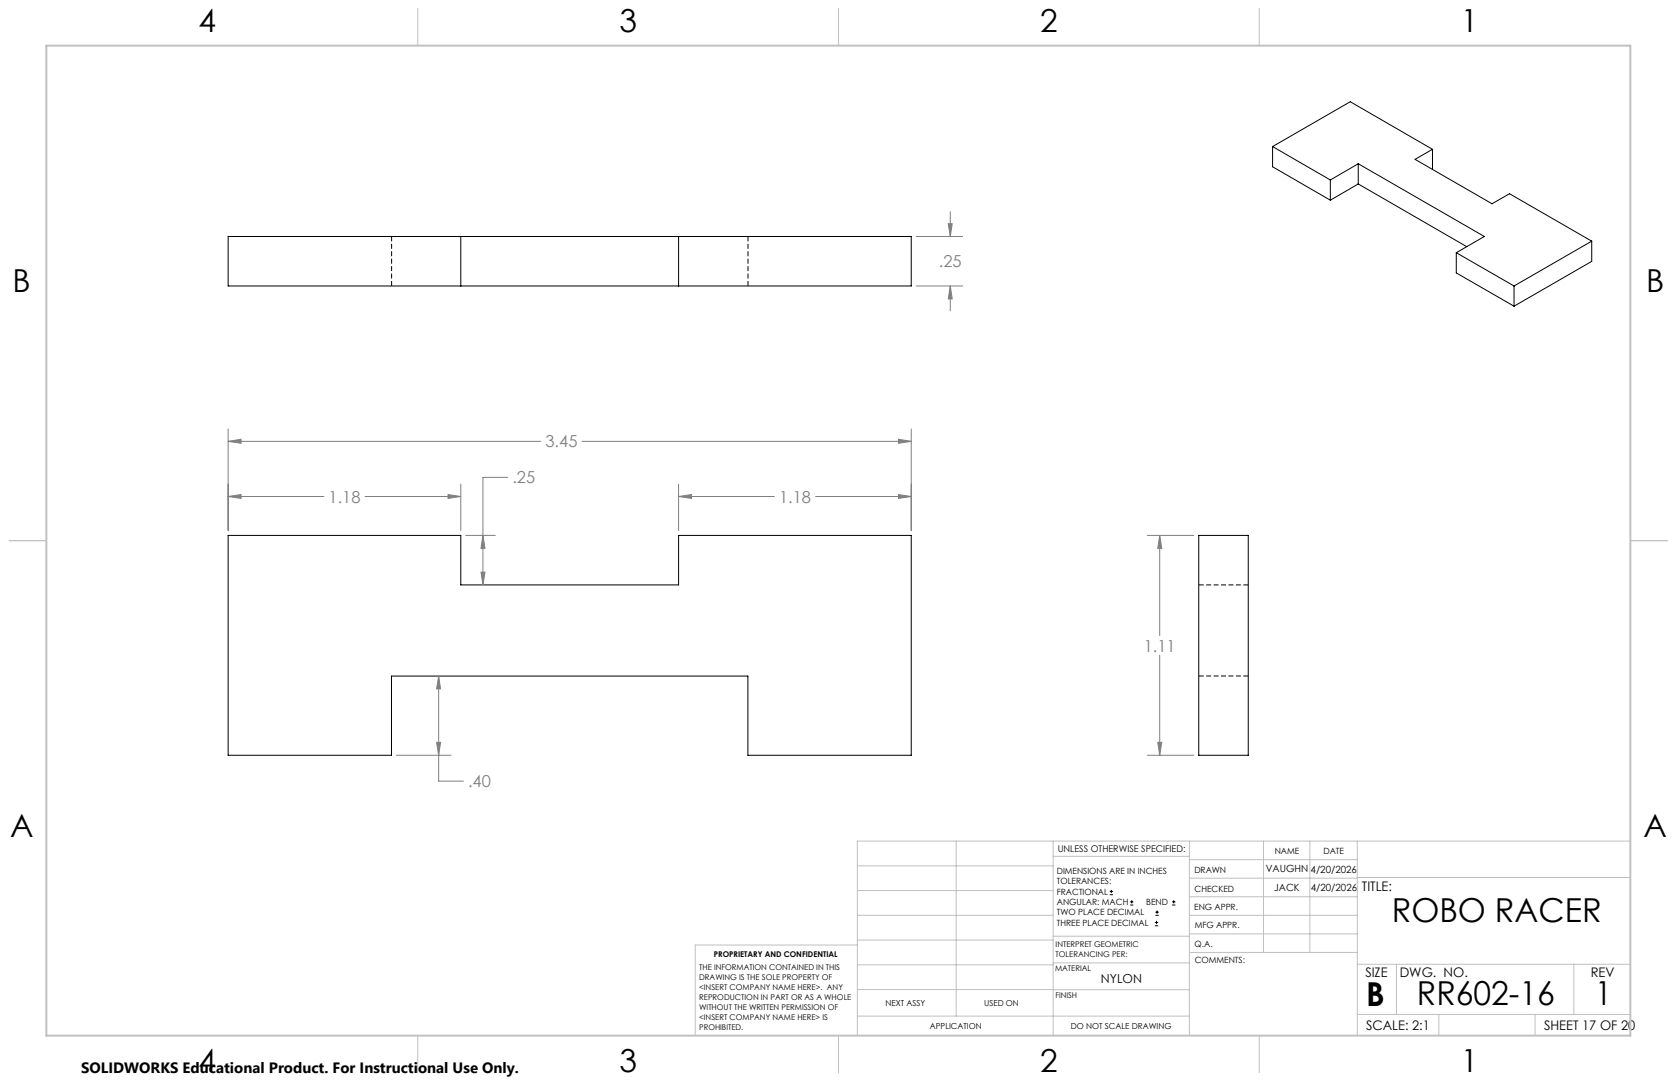
[picture p19: page 17]
SCALE: 2:1; DWG. NO.; REV

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

CHECKED | JACK | 4/20/2026 | TITLE: ROBO RACER

ENG APPR.
MFG APPR.

INTERPRET GEOMETRIC TOLERANCING PER: | Q.A.

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

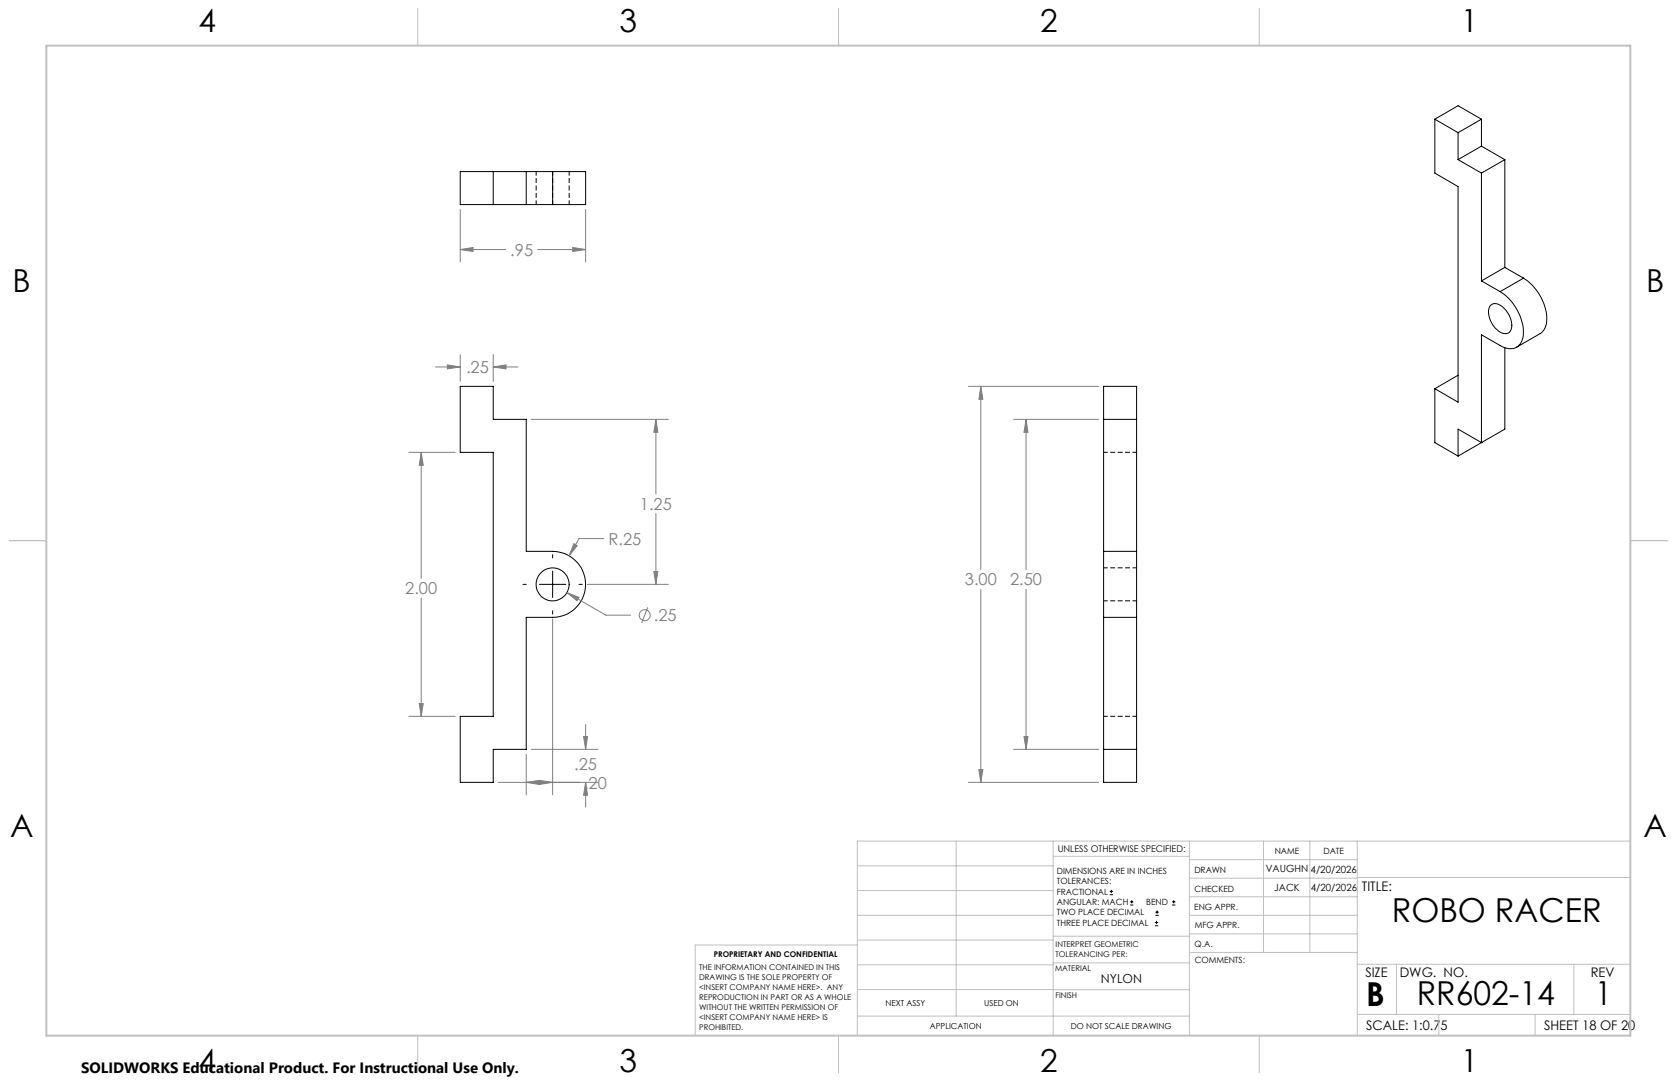
[picture p20: page 18]
SCALE: 1:0.75; DWG. NO.; REV

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

CHECKED | JACK | 4/20/2026 | TITLE: ROBO RACER

ENG APPR.
MFG APPR.

INTERPRET GEOMETRIC TOLERANCING PER: | Q.A.

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

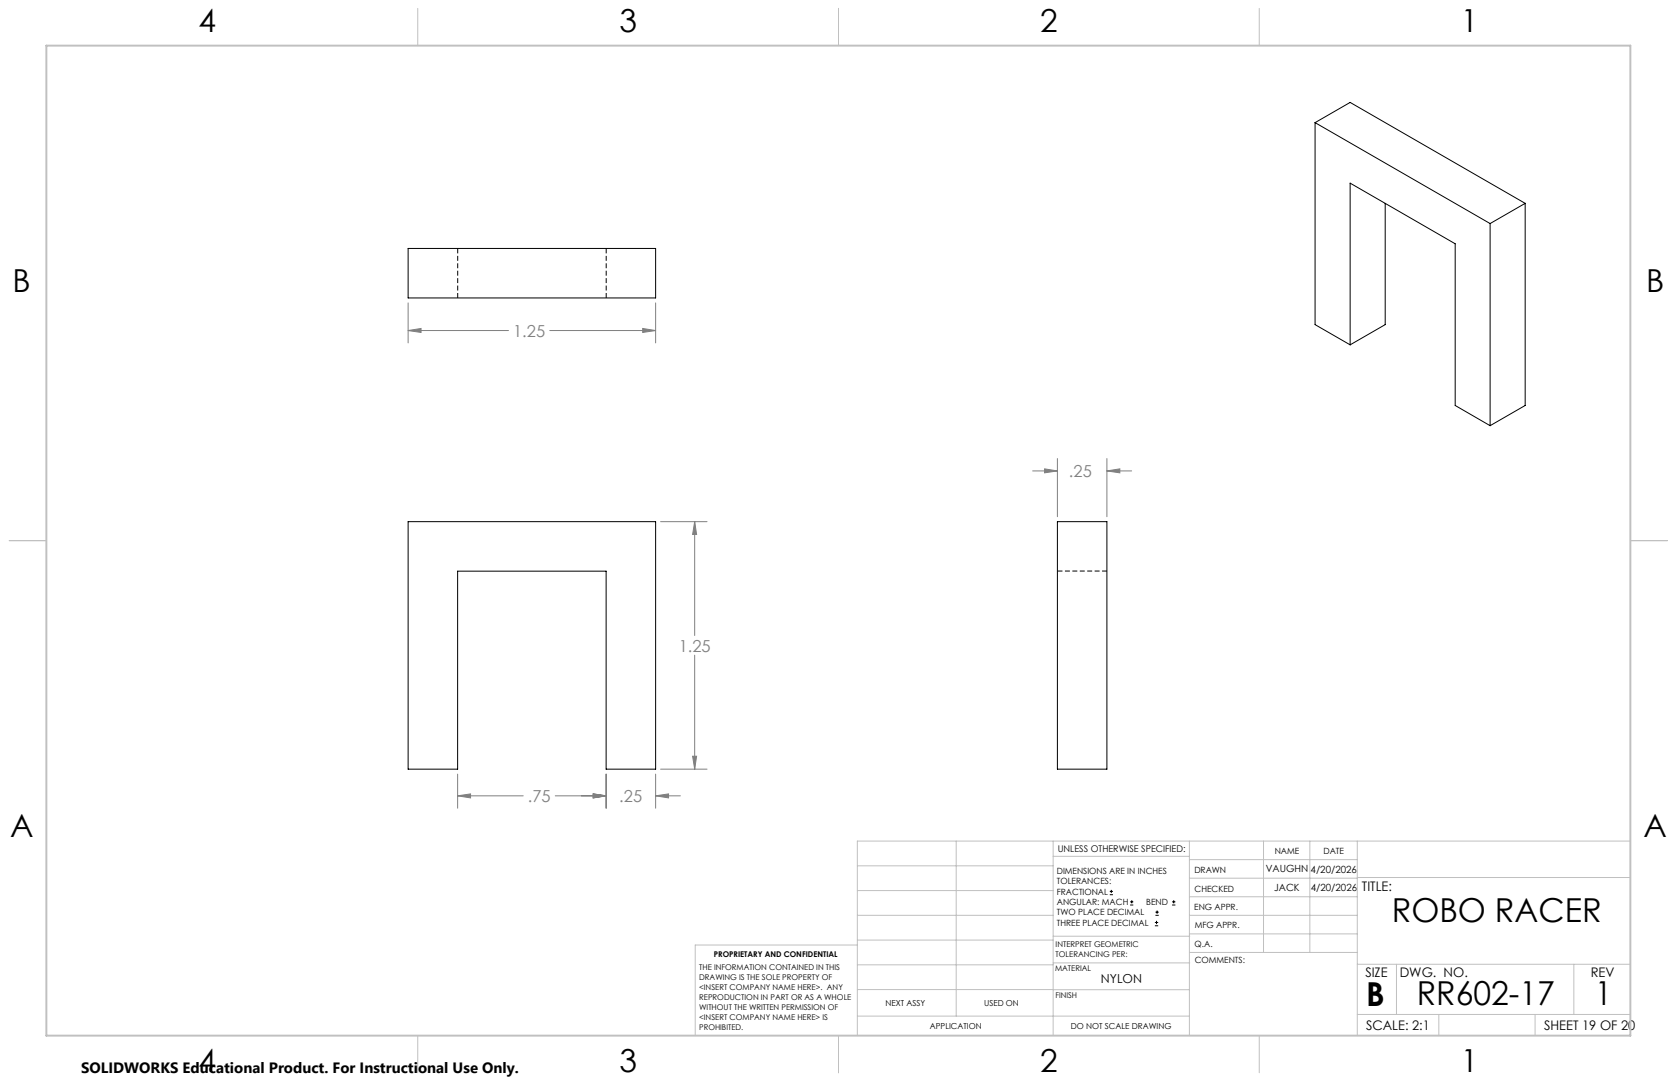
[picture p21: page 19]
SCALE: 2:1; DWG. NO.; REV

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

CHECKED | JACK | 4/20/2026 | TITLE: ROBO RACER

ENG APPR.
MFG APPR.

INTERPRET GEOMETRIC TOLERANCING PER: | Q.A.

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

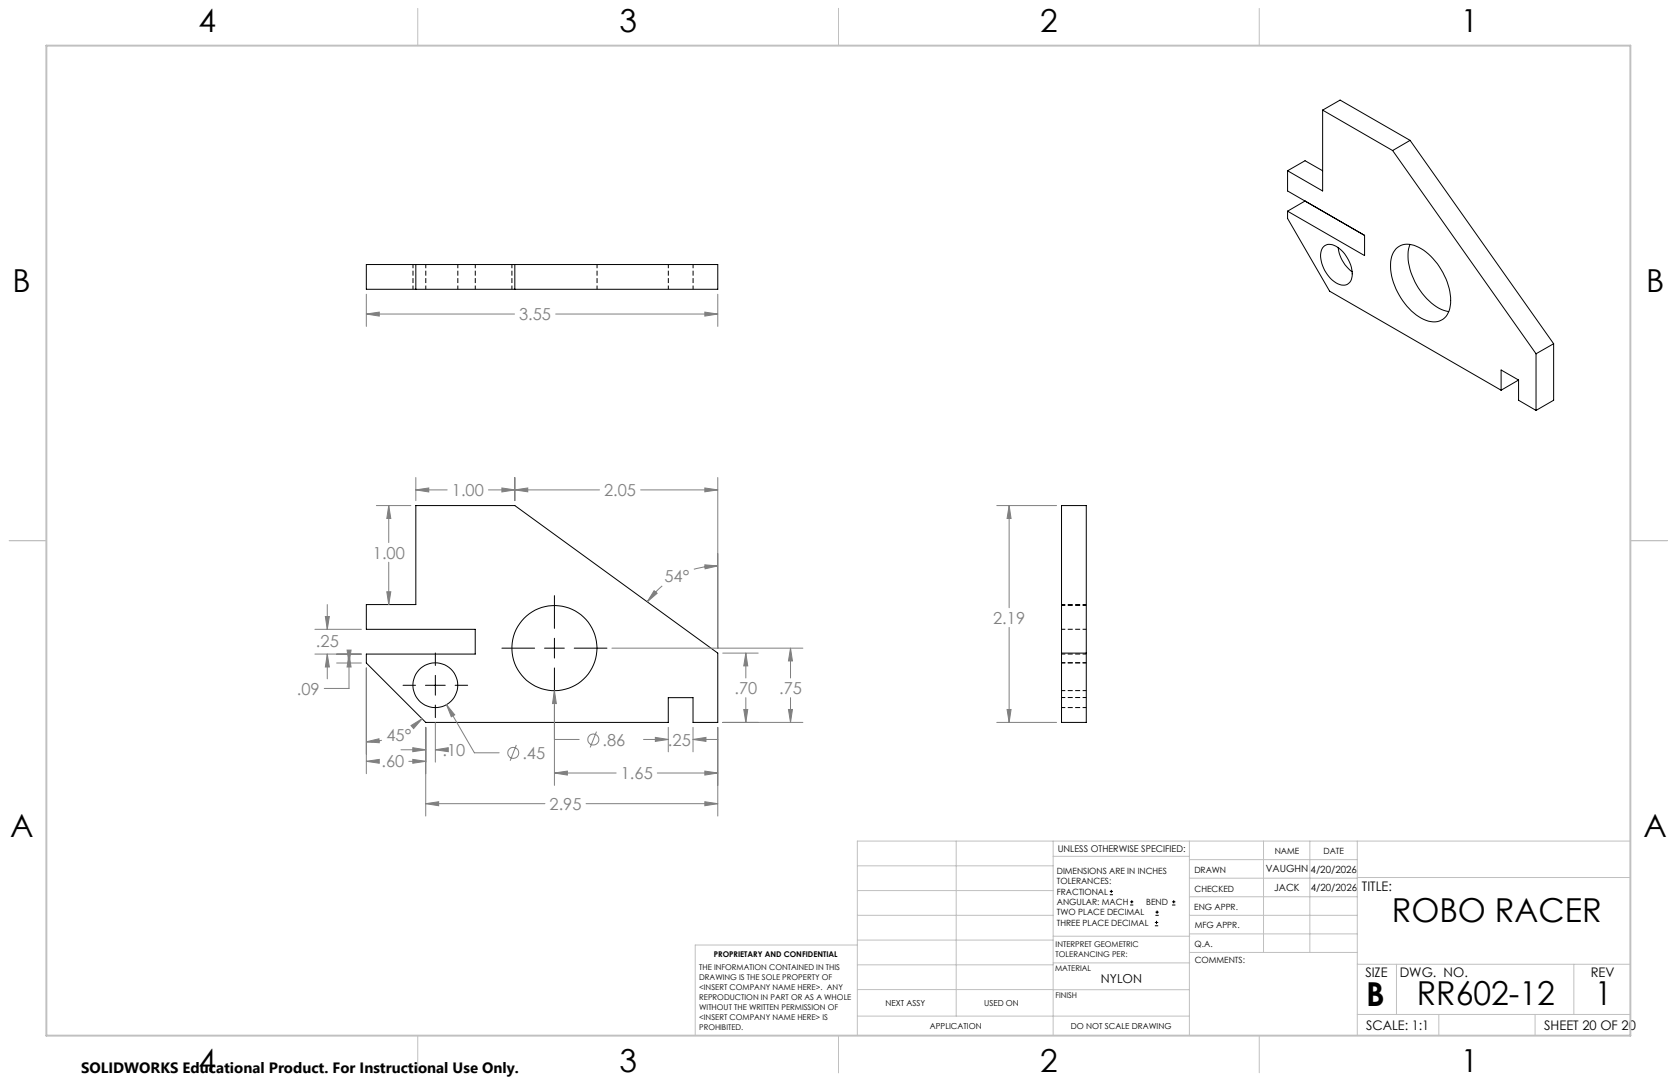
[picture p22: page 20]
DWG. NO.; REV

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

CHECKED | JACK | 4/20/2026 | TITLE: ROBO RACER

ENG APPR.
MFG APPR.

INTERPRET GEOMETRIC TOLERANCING PER: | Q.A.

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
