VaughnLuce/LineFollowingRobot/FinalElectricalSchematic.pdf

## TOGGLE SWITCH

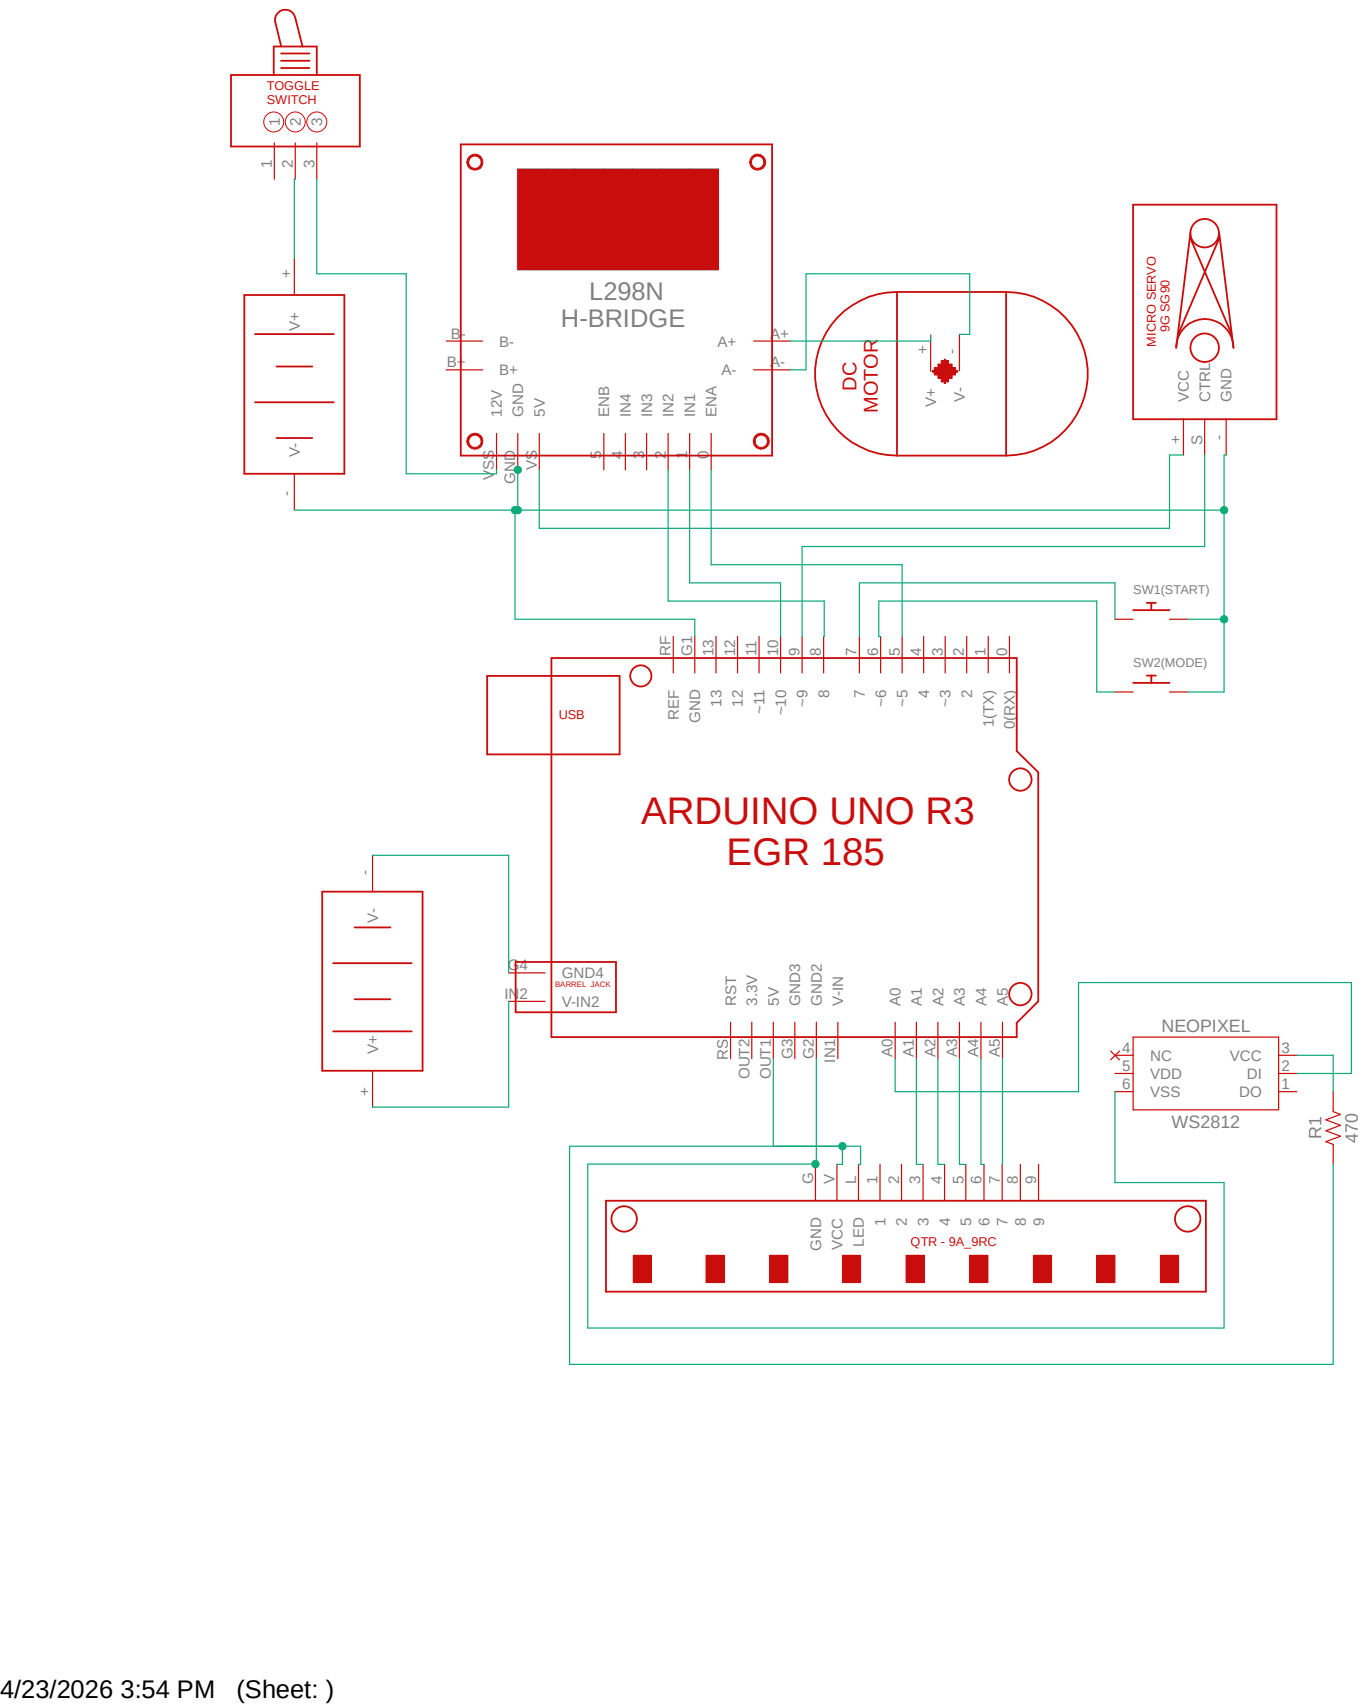
[picture p23: page 1]
4/23/2026 3:54 PM (Sheet: ); 12V VSS; GND GND 5V VS; IN⁴; 1 ENA; 0 ENB; H-BRIDGE; VCC; + CTRL S GND; 1 LED; L VCC; V GND G; SW1(START); SW2(MODE); ARDUINO UNO R3; EGR 185 BARREL JACK USB; DC MOTOR; MICRO SERVO 9G SG⁹⁰; QTR - 9A_9RC

9 ~10 10 ~11 11 12 12 13 13 GND G1 REF RF A5 A5 A4 A4 A3 A3 A2 A2 A1 A1 A0 A0 V-IN IN1 GND2 G2 GND3 G3 5V OUT1 3.3V OUT2 RST RS GND4 G4 V-IN2 IN2

9 NEOPIXELDO 1 DI 2 VCC 3 NC 4 VDD 5 VSS 6 R1
